Yang-Ci/Rebot-Arm/hardware/reBot_B601_DM/readme.md

# 🤖 reBot DevArm Open Source Hardware Specification

<p align="center">
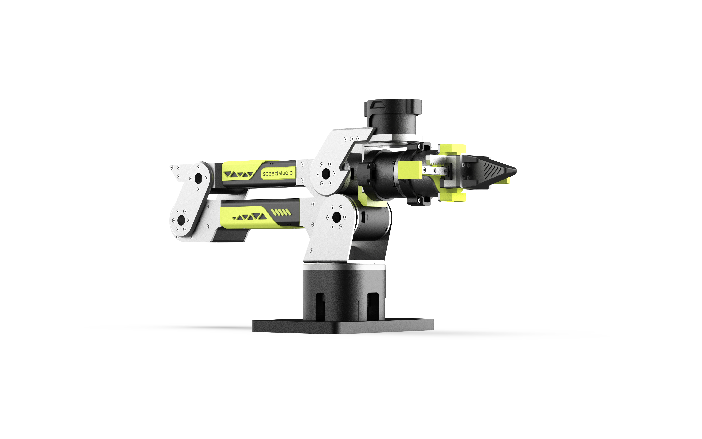
[picture p7: media/v1.1.png]
reBot-DevArm Banner
  
</p>
<p align="center">
  <strong>
    <a href="./readme_zh.md">简体中文</a> &nbsp;|&nbsp;
    <a href="./readme.md">English</a> &nbsp;|&nbsp;
    <a href="./readme_jp.md">日本語</a>&nbsp;|&nbsp;
    <a href="./readme_fr.md">français</a>&nbsp;|&nbsp;
    <a href="./readme_es.md">Español</a>
  </strong>
</p>

| Date | Version | File Name | Changelog |
|---|---|---|---|
|  2026-03-31 | v1.0 |  reBot_B601_DM_v1.0_20260331.step  | Initial upload |
|  2026-04-25 | v1.1 |  reBot_B601_DM_v1.1_20260425.step  | Added Cable Restraint for the 3 end joint motors to prevent loosening and disconnection. Fixed Joint 1 model from 4310 to 4340P. Added CNC part 02_Base_Reinforcement_Part.step at the bottom to enhance base rigidity. |

This BOM is for the reBot Arm B601 DM robotic arm, which uses Damiao 43 series motors. The other version, reBot Arm B601 RS, uses RobStride motors; [see the BOM here](../reBot_B601_RS/README.md).

# 📦 File Structure
*   3D_Printed_Parts/: Step files for all 3D printed parts.
*   Metal_Parts/: Step files for all CNC machined metal parts.
*   Purchased_Parts/: Step files for all purchased components.
*   reBot_B601_DM_v1.1_20260415.step: Full robotic arm assembly file.

# 🛒[Gets All Parts](https://www.seeedstudio.com/reBot-Arm-B601-DM-Bundle.html)
- We offer five kit options:
  - **Arm Body Motor Kit**: Includes only motors and wiring harnesses for the robotic arm.
  - **Arm Body Structural Kit**: Includes only mechanical structural components.
  - **Gripper Complete Kit**: Includes motors, wiring harnesses and structural components for the gripper.
  - **Full Kit**: Includes the complete set of the robotic arm body and gripper.
  - **Pre‑assembled Robotic Arm**: Fully assembled finished robotic arm.

# 📊 Bill of Materials (BOM)

> [!WARNING]
> Declaration: The published BOM does **not** represent the final shipping version from Seeed. This open-source v1.1 is optimized for developers to reproduce at minimal cost, with some non-essential details simplified.
> The final Seeed production version will include metal laser engraving for foolproofing, some 3D printed parts will be replaced with metal for durability, clearances and machining tolerances will be adjusted for factory variation (balancing precision and cost), and custom wiring (e.g., braided sleeve protection) will be added at extra cost. However, the mechanical structure remains identical.

---

## 🖨️ 3D Printed Parts

| Part Description | Image | File Name | Material | Qty | Notes |
|---|---|---|---|---|---|
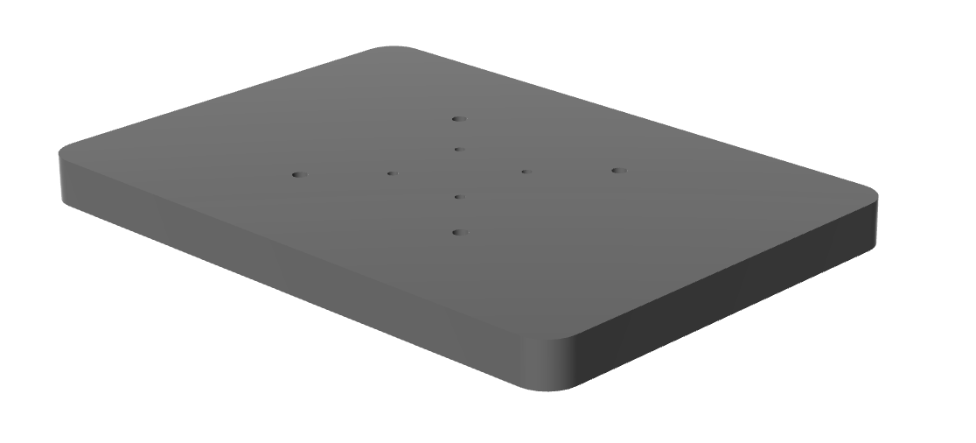
[picture p8: hardware/reBot_B601_DM/3D_Printed_Parts/images/02-BASE.png]
| Robotic Arm Base Platform |  | 01_BASE_Plate.step | Bambu ABS Black | 1 | 0.4 nozzle, 0.2 layer height, 30% infill |
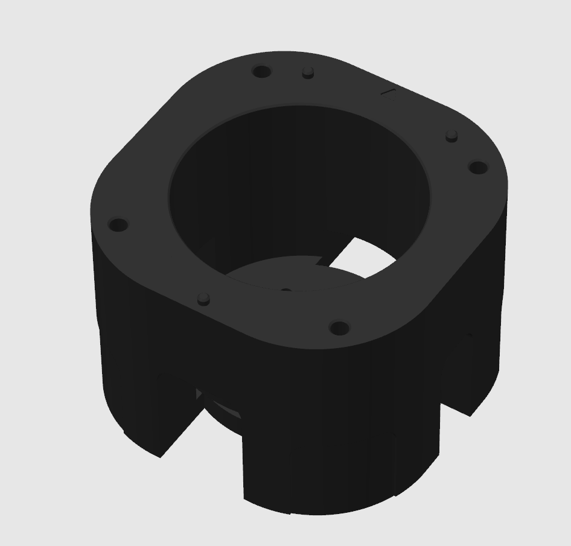
[picture p9: hardware/reBot_B601_DM/3D_Printed_Parts/images/02-BASE_02.png]
| Robotic Arm Base Link |  | 01_BASE_Link.step | Bambu ABS Black | 1 | 0.4 nozzle, 0.2 layer height, 30% infill |
| Upper Arm Left Filler |  | 01_Upper_Arm_Fuller_L.step | Bambu PLA Black & Green | 1 | 0.4 nozzle, 0.2 layer height, 15% infill |
| Upper Arm Right Filler |  | 01_Upper_Arm_Fuller_R.step | Bambu PLA Black & Green | 1 | 0.4 nozzle, 0.2 layer height, 15% infill |
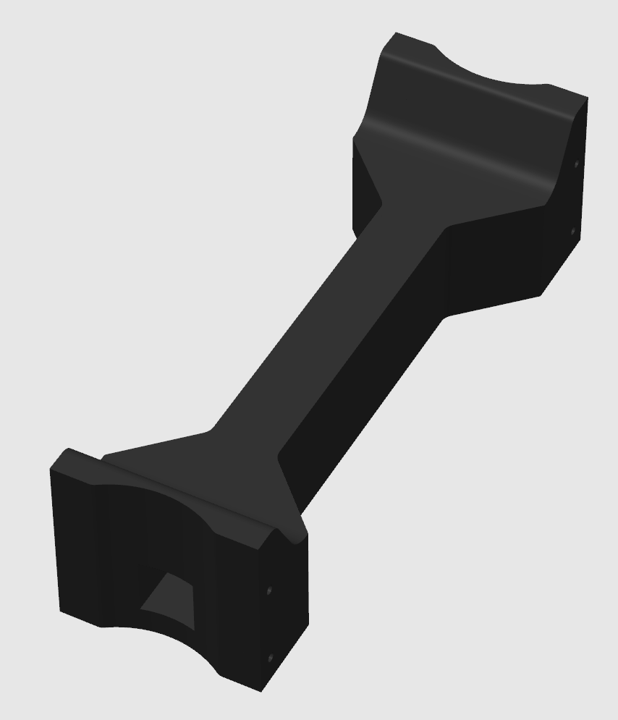
[picture p10: hardware/reBot_B601_DM/3D_Printed_Parts/images/02-DOWN-FILLING.png]
| Upper Arm Center Filler |  | 01_Upper_Arm_Fuller_M.step | Bambu ABS Black | 1 | 0.4 nozzle, 0.2 layer height, 30% infill |
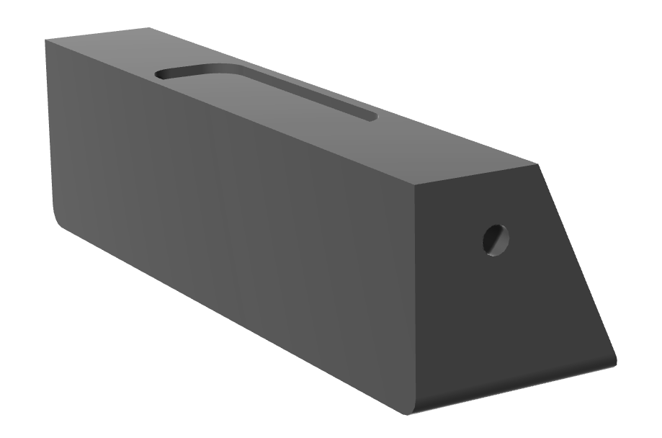
[picture p11: hardware/reBot_B601_DM/3D_Printed_Parts/images/02-SPACER-DOWN.png]
| Upper Arm Horizontal Limit Block |  | 01_Upper_Arm_Limit.step | Bambu ABS Black | 1 | 0.4 nozzle, 0.2 layer height, 30% infill |
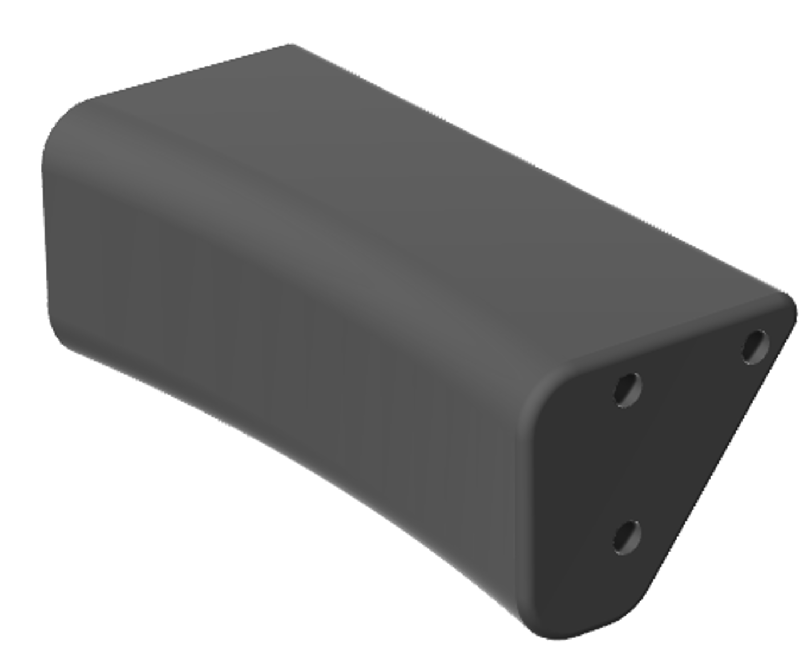
[picture p12: hardware/reBot_B601_DM/3D_Printed_Parts/images/02-HANDLE.png]
| Arm Handle |  | 01_Arm_Handle.step | Bambu ABS Black | 1 | 0.4 nozzle, 0.2 layer height, 30% infill |
| Lower Arm Left Filler |  | 01_Lower_Arm_Filler_L.step | Bambu PLA Black & Green | 1 | 0.4 nozzle, 0.2 layer height, 15% infill |
| Lower Arm Right Filler |  | 01_Lower_Arm_Filler_R.step | Bambu PLA Black & Green | 1 | 0.4 nozzle, 0.2 layer height, 15% infill |
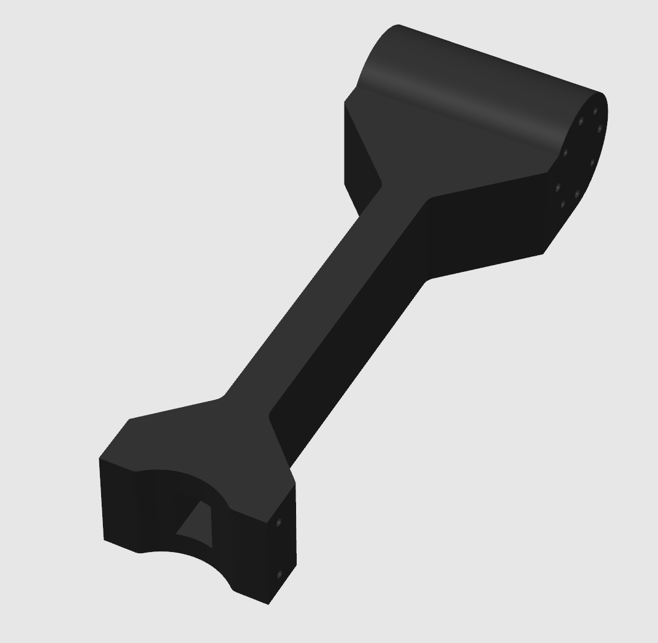
[picture p13: hardware/reBot_B601_DM/3D_Printed_Parts/images/02-UP-FILLING.png]
| Lower Arm Center Filler |  | 01_Lower_Arm_Filler_M.step | Bambu ABS Black | 1 | 0.4 nozzle, 0.2 layer height, 30% infill |
| Upper Arm Cover |  | 01_Upper_Arm_Cover.step | Bambu PLA Green | 1 | 0.4 nozzle, 0.2 layer height, 15% infill |
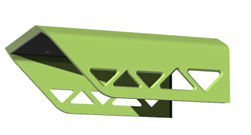
[picture p14: hardware/reBot_B601_DM/3D_Printed_Parts/images/02-UP-COVER.png]
| Lower Arm Cover |  | 01_Lower_Arm_Cover.step | Bambu PLA Green | 1 | 0.4 nozzle, 0.2 layer height, 15% infill |
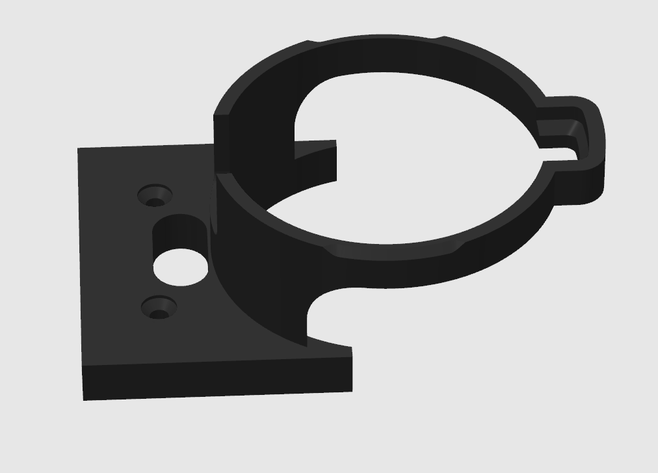
[picture p15: hardware/reBot_B601_DM/3D_Printed_Parts/images/02-MOTOR-COVER.png]
| Motor 5 Protection Cover |  | 01_Motor_Cover.step | Bambu ABS Black | 1 | 0.4 nozzle, 0.2 layer height, 30% infill |
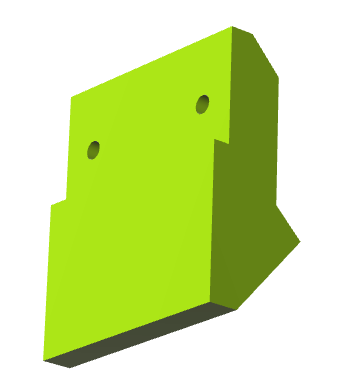
[picture p16: hardware/reBot_B601_DM/3D_Printed_Parts/images/02-SPACER.png]
| Gripper Horizontal Limit |  | 01_Lower_Arm_Limit.step | Bambu PLA Green | 1 | 0.4 nozzle, 0.2 layer height, 15% infill |
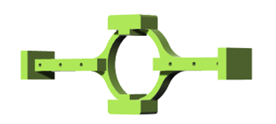
[picture p17: hardware/reBot_B601_DM/3D_Printed_Parts/images/02-3D-RAIL-BRACKET.png]
| Gripper Slider Support Bracket |  | 01-Rail-Bracket.step | Bambu PLA Green | 1 | 0.4 nozzle, 0.2 layer height, 15% infill |
| Gripper Finger |  | 01_Finger.step | Bambu ABS Black | 2 | 0.4 nozzle, 0.2 layer height, 45% infill |
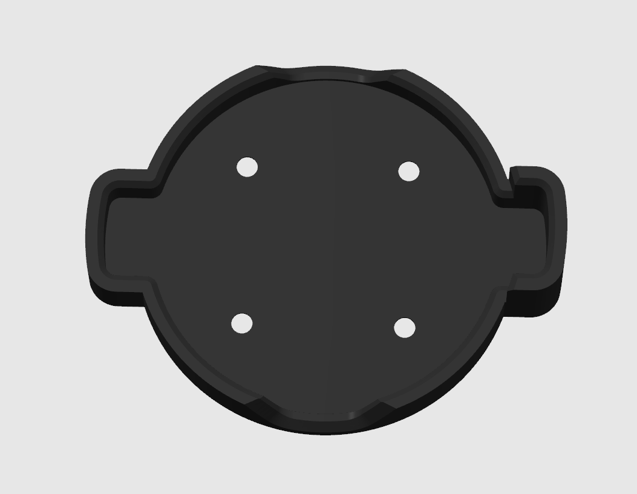
[picture p18: hardware/reBot_B601_DM/3D_Printed_Parts/images/01_Joint5_Cable Restraint_A.png]
| Motor 5 Cable Restraint |  | 01_Joint5_Cable Restraint_A.step | Bambu PLA Green | 1 | 0.4 nozzle, 0.2 layer height, 15% infill |
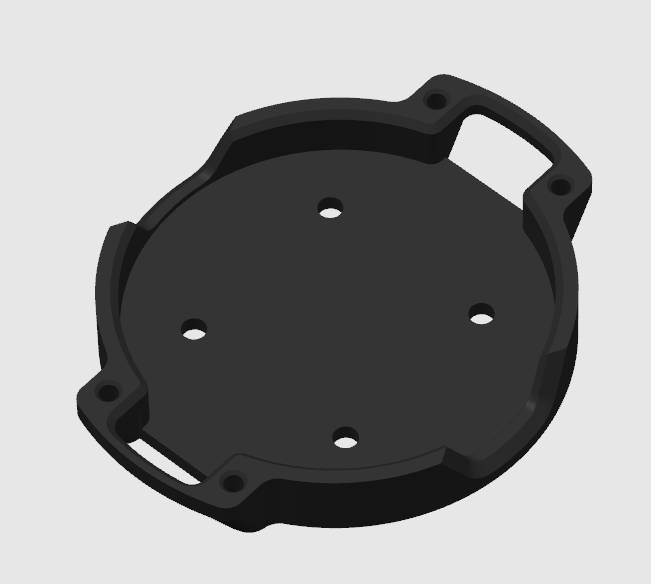
[picture p19: hardware/reBot_B601_DM/3D_Printed_Parts/images/01_Joint6_7_Cable Restraint_A.png]
| Motor 6 & 7 Cable Restraint A |  | 01_Joint6_7_Cable Restraint_A.step | Bambu ABS Black | 2 | 0.4 nozzle, 0.2 layer height, 30% infill |
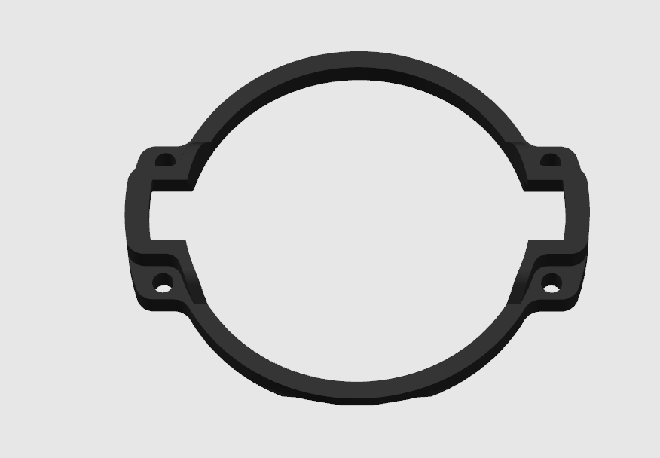
[picture p20: hardware/reBot_B601_DM/3D_Printed_Parts/images/01_Joint6_7_Cable Restraint_B.png]
| Motor 6 & 7 Cable Restraint B |  | 01_Joint6_7_Cable Restraint_B.step | Bambu ABS Black | 2 | 0.4 nozzle, 0.2 layer height, 30% infill |
| - | Reference Price | Average **50$** | | | Price varies by material cost and printing time |

### 🧩 Printing Recommendations
- Layer height: 0.2 mm
- Nozzle: 0.4 mm
- Supports: Add as needed
- Materials: High-temperature and load-bearing parts use ABS with 30–80% infill; may also use nylon or carbon-fiber reinforced materials. Cosmetic parts use PLA with 15% infill.
- Recommended materials for load-bearing parts:

---

## 🔩 CNC Machined Metal Parts

> [!WARNING]
> Some parts that can be replaced with 3D printing are noted in the remarks, which can significantly reduce costs.

| Part Description | Image | File Name | Material | Qty | Machining | Notes |
|---|---|---|---|---|---|---|
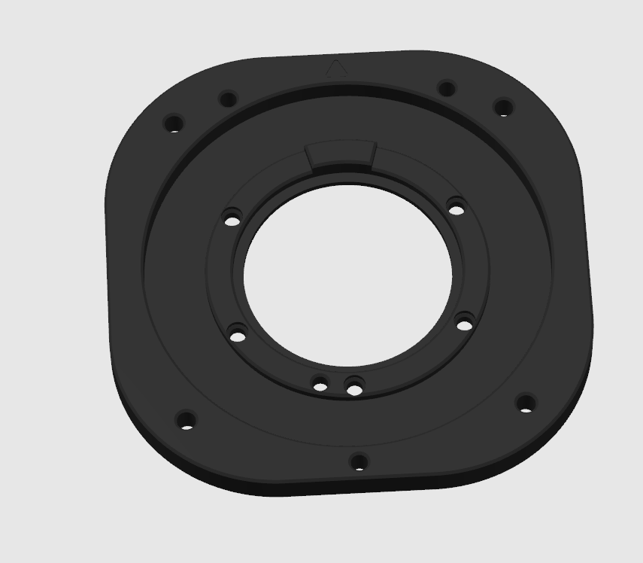
[picture p21: hardware/reBot_B601_DM/Metal_Parts/images/02_Base_Reinforcement_Part.png]
| Motor 1 Bearing Mount |  | 02_Base_Reinforcement_Part.step | Aluminum Alloy 5052 | 1 | CNC | Can be 3D printed in ABS with high infill to reduce cost |
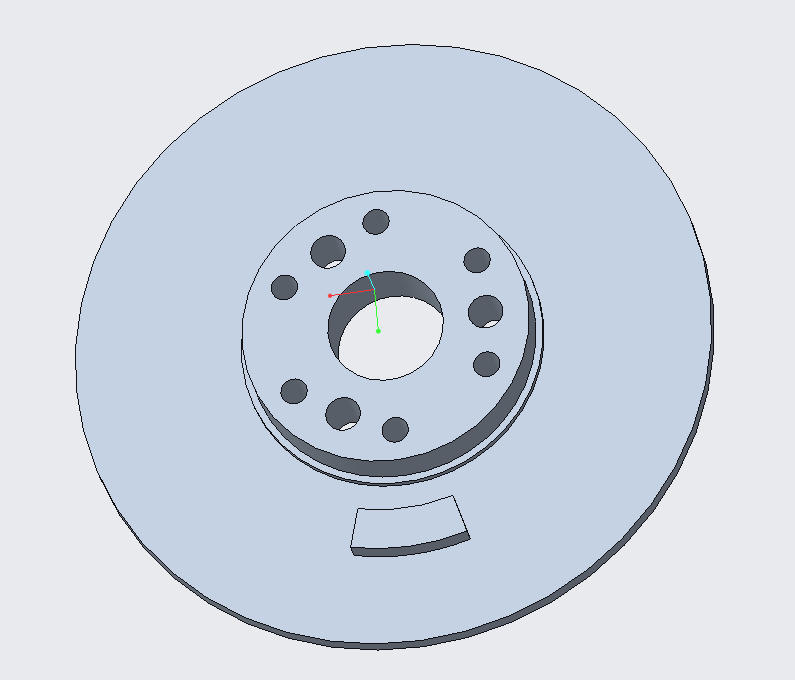
[picture p22: hardware/reBot_B601_DM/Metal_Parts/images/02_Arm_Yaw_Limit.png]
| Motor 1 Rotation Axis |  | 02_Arm_Yaw_Limit.step | Aluminum Alloy 5052 | 1 | CNC | Added yaw angle motion limit |
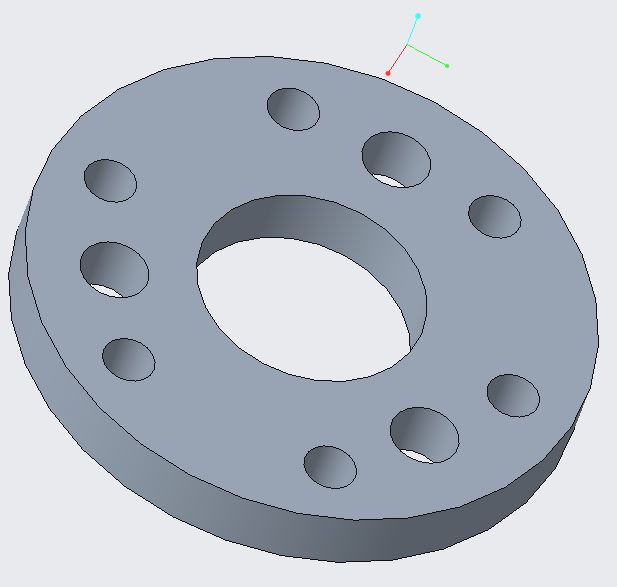
[picture p23: hardware/reBot_B601_DM/Metal_Parts/images/02_Motor_Front_Spacer.png]
| Motor 2–5 Front Spacer |  | 02_Motor_Front_Spacer.step | Aluminum Alloy 5052 | 4 | CNC | Can be 3D printed in ABS with 30% infill |
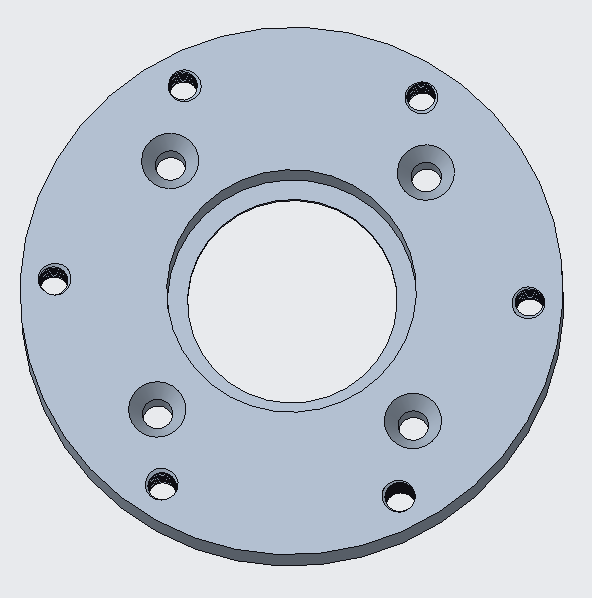
[picture p24: hardware/reBot_B601_DM/Metal_Parts/images/02_Motor_Back_Spacer.png]
| Motor 2–4 Rear Spacer |  | 02_Motor_Back_Spacer.step | Aluminum Alloy 5052 | 3 | CNC | |
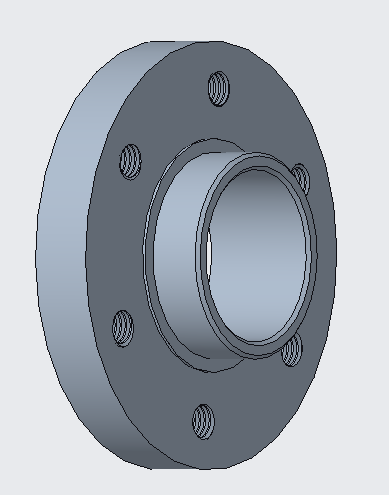
[picture p25: hardware/reBot_B601_DM/Metal_Parts/images/02_FLANGE.png]
| Motor 2–4 Rear Flange |  | 02_FLANGE.step | Aluminum Alloy 5052 | 3 | CNC | |
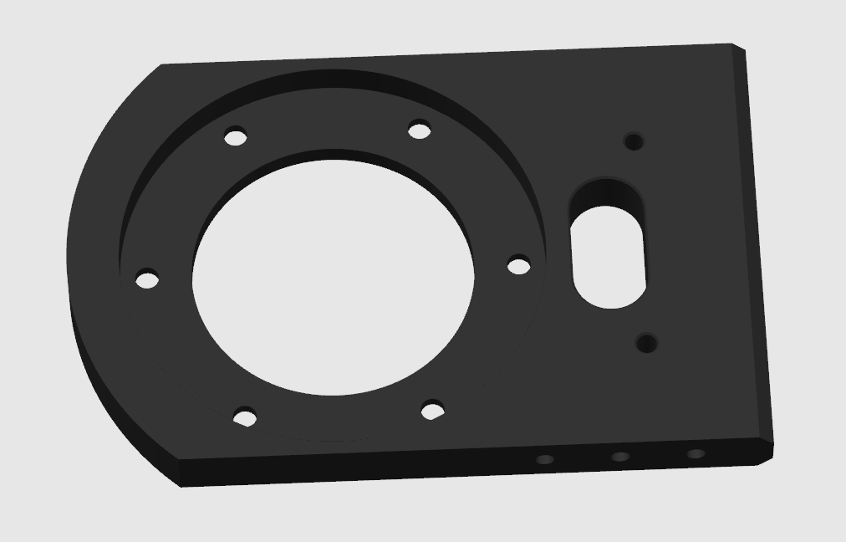
[picture p26: hardware/reBot_B601_DM/Metal_Parts/images/02_Wrist_Bracket.png]
| Wrist Motor 5 Bracket |  | 02_Wrist_Bracket.step | Aluminum Alloy 5052 | 1 | CNC | |
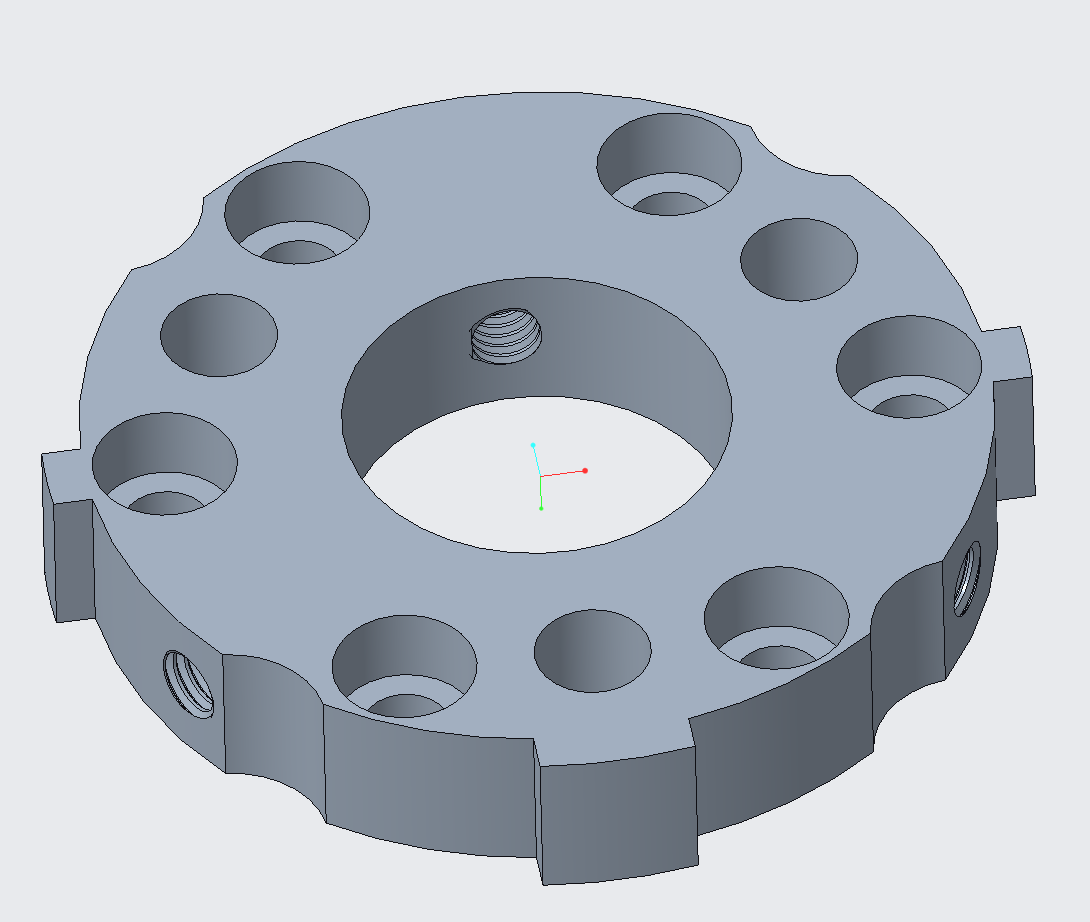
[picture p27: hardware/reBot_B601_DM/Metal_Parts/images/02_Gripper_Connector_A.png]
| Gripper Connector A |  | 02_Gripper_Connector_A.step | Aluminum Alloy 5052 | 1 | CNC | |
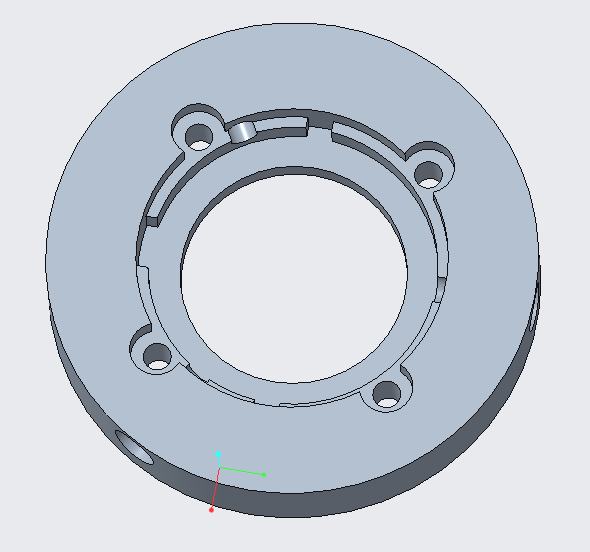
[picture p28: hardware/reBot_B601_DM/Metal_Parts/images/02_Gripper_Connector_B.png]
| Gripper Connector B |  | 02_Gripper_Connector_B.step | Aluminum Alloy 5052 | 1 | CNC | |
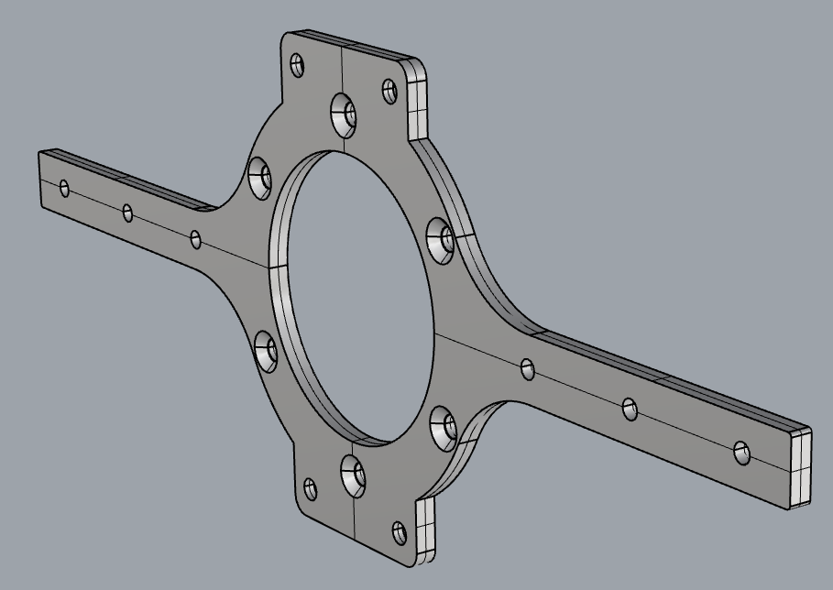
[picture p29: hardware/reBot_B601_DM/Metal_Parts/images/02_Slider_Bracket.png]
| Gripper Slider Metal Bracket |  | 02_Slider_Bracket.step | Aluminum Alloy 5052 | 1 | CNC | Can be 3D printed in ABS with high infill, not recommended for long-term use |
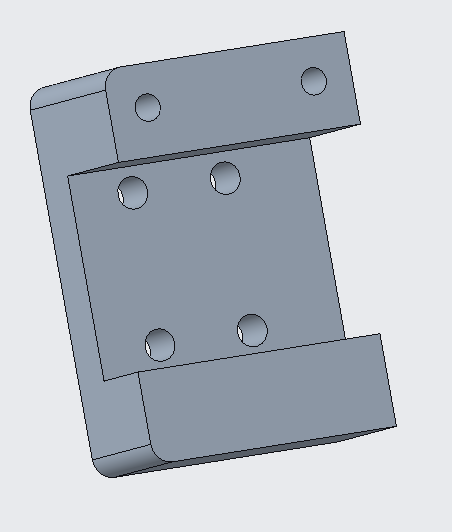
[picture p30: hardware/reBot_B601_DM/Metal_Parts/images/02_Slider_Extension.png]
| Slider to Gripper Extension |  | 02_Slider_Extension.step | Aluminum Alloy 5052 | 2 | CNC | |
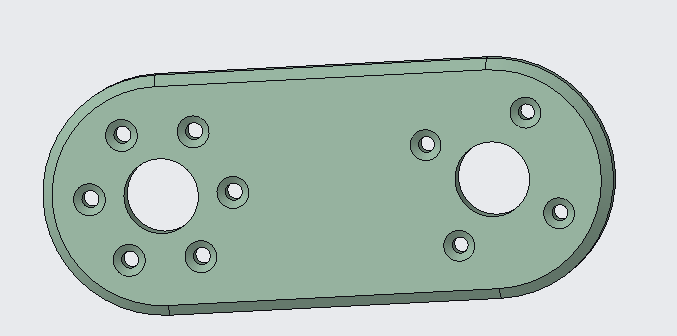
[picture p31: hardware/reBot_B601_DM/Metal_Parts/images/02_Lower_Upper_Link_L.png]
| Upper-Lower Arm Link Left |  | 02_Lower_Upper_Link_L.step | Aluminum Alloy 5052 | 1 | CNC | |
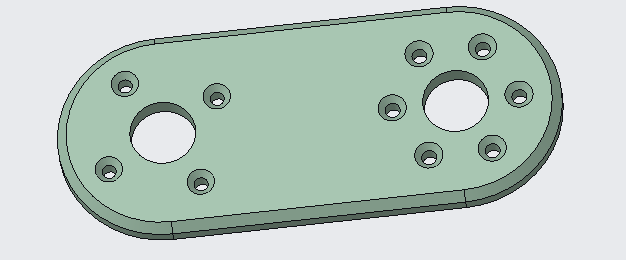
[picture p32: hardware/reBot_B601_DM/Metal_Parts/images/02_Lower_Upper_Link_R.png]
| Upper-Lower Arm Link Right |  | 02_Lower_Upper_Link_R.step | Aluminum Alloy 5052 | 1 | CNC | |
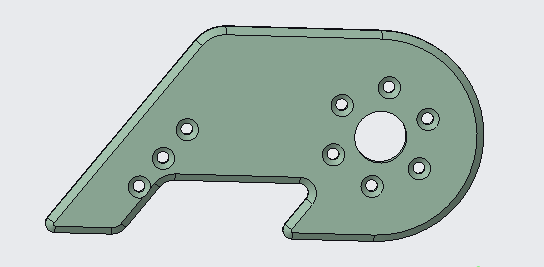
[picture p33: hardware/reBot_B601_DM/Metal_Parts/images/02_Lower_Wrist_Link_L.png]
| Lower Arm-Wrist Link Left |  | 02_Lower_Wrist_Link_L.step | Aluminum Alloy 5052 | 1 | CNC | |
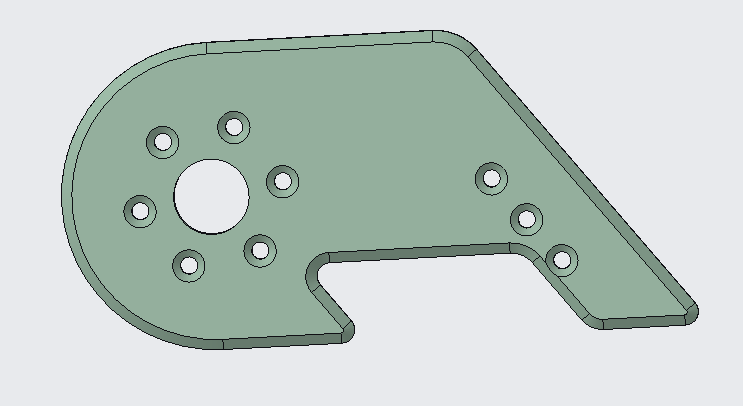
[picture p34: hardware/reBot_B601_DM/Metal_Parts/images/02_Lower_Wrist_Link_R.png]
| Lower Arm-Wrist Link Right |  | 02_Lower_Wrist_Link_R.step | Aluminum Alloy 5052 | 1 | CNC | |
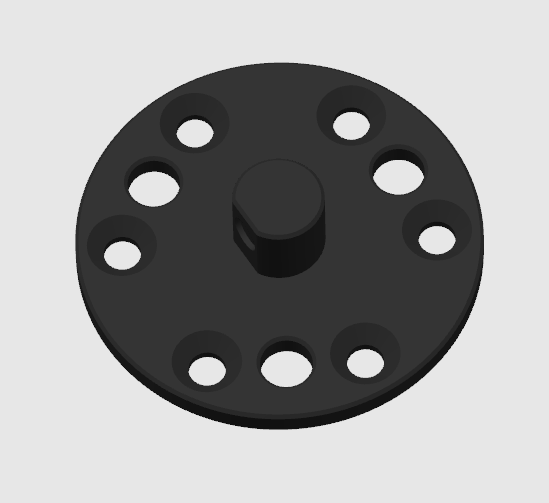
[picture p35: hardware/reBot_B601_DM/Metal_Parts/images/02_Gear_Connector.png]
| Gear Connector |  | 02_Gear_Connector.step | Aluminum Alloy 5052 | 1 | CNC | |
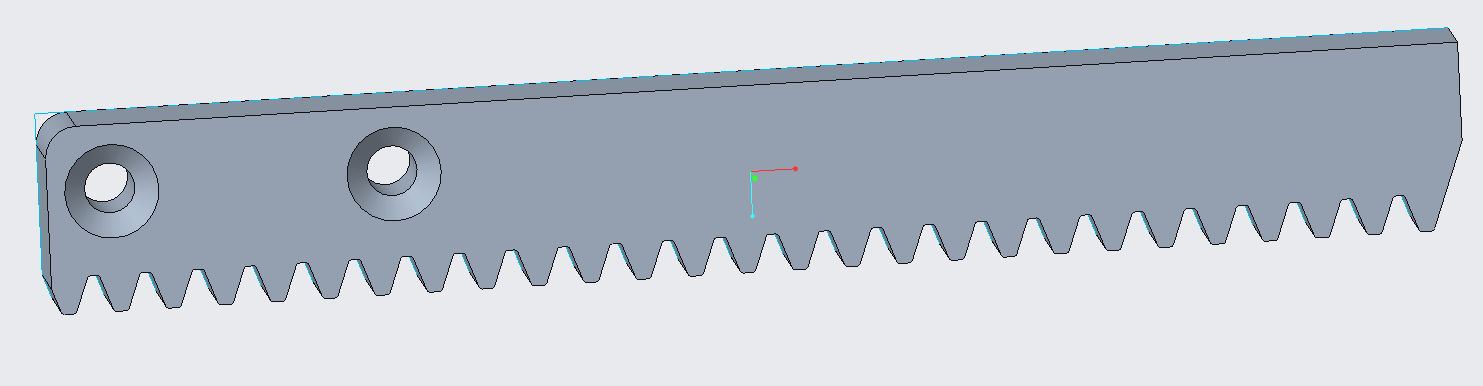
[picture p36: hardware/reBot_B601_DM/Metal_Parts/images/Rack.png]
| Rack |  | 02_Rack.step | Aluminum Alloy 5052 | 2 | CNC | |
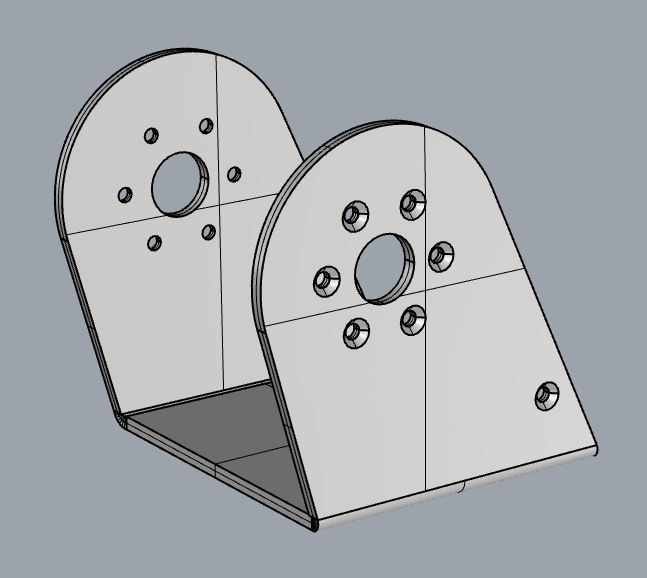
[picture p37: hardware/reBot_B601_DM/Metal_Parts/images/Link1.png]
| Link 1 |  | 03_Link1.step | Aluminum Alloy 5052 | 1 | CNC + Sheet Metal | |
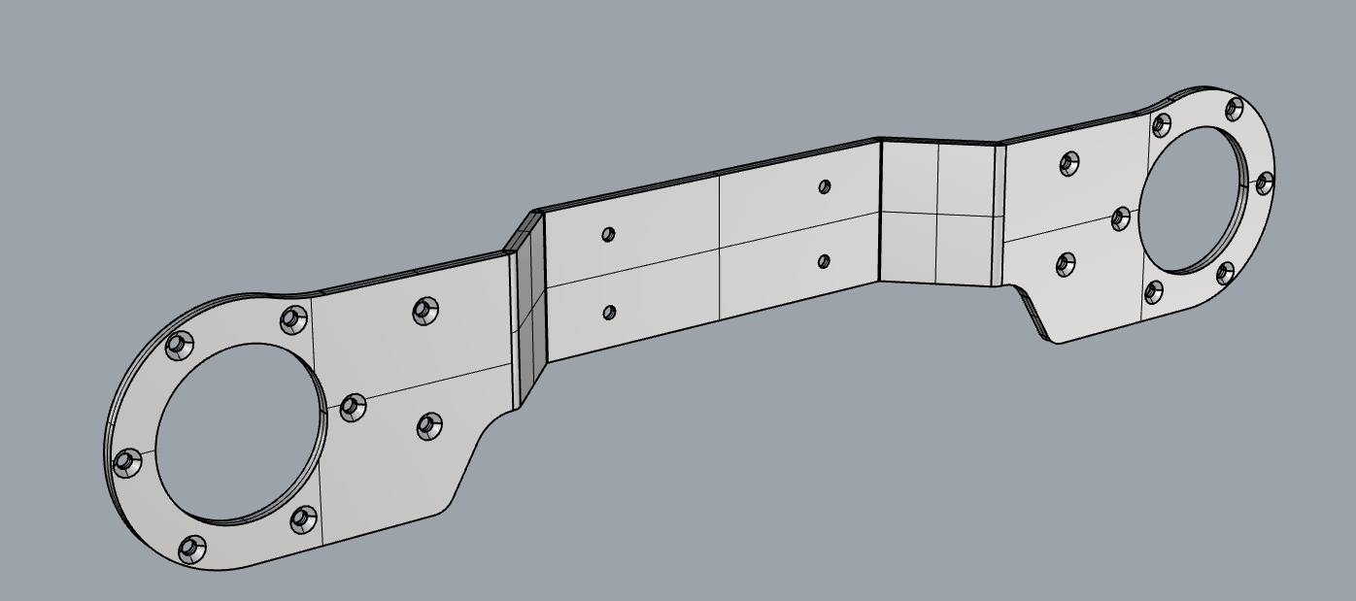
[picture p38: hardware/reBot_B601_DM/Metal_Parts/images/Link2.png]
| Link 2 |  | 03_Link2.step | Aluminum Alloy 5052 | 2 | CNC + Sheet Metal | |
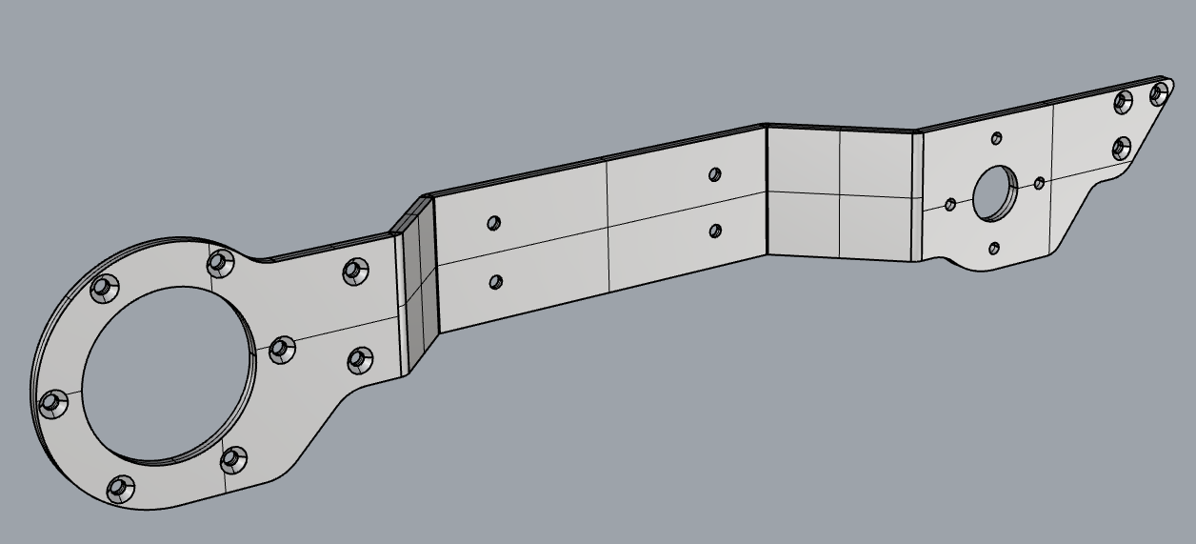
[picture p39: hardware/reBot_B601_DM/Metal_Parts/images/Link3_L.png]
| Link 3 Left |  | 03_Link3_L.step | Aluminum Alloy 5052 | 1 | CNC + Sheet Metal | |
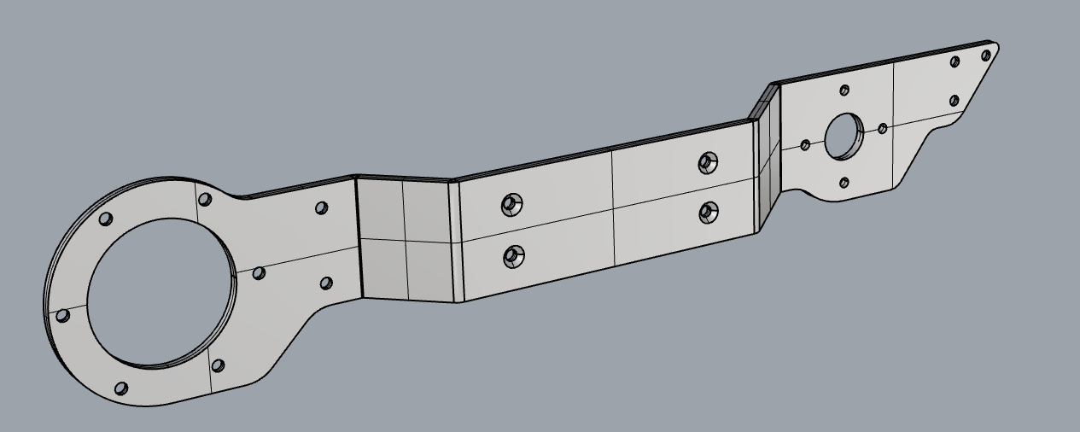
[picture p40: hardware/reBot_B601_DM/Metal_Parts/images/Link3_R.png]
| Link 3 Right |  | 03_Link3_R.step | Aluminum Alloy 5052 | 1 | CNC + Sheet Metal | |
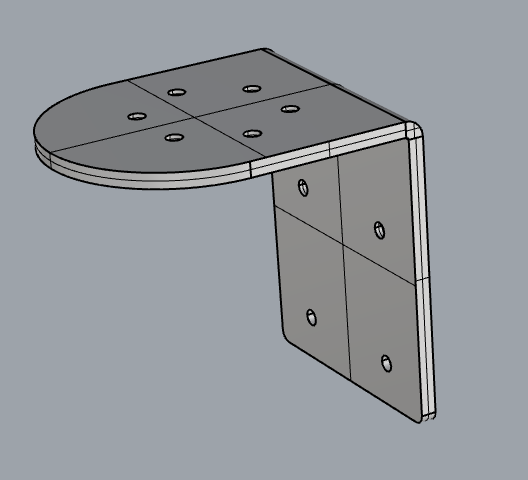
[picture p41: hardware/reBot_B601_DM/Metal_Parts/images/Link5.png]
| Link 5 |  | 03_Link5.step | Aluminum Alloy 5052 | 1 | CNC + Sheet Metal | |
| - | Market Reference Price | Average **250$** | | | Price varies by aluminum cost, tolerance requirements, lead time |

### 🧩 Machining Specifications
- Key dimension tolerance: ±0.02 mm GB/T1840-M
- Surface finish: Anodizing / Sandblasting
- Mating parts recommended: H7 / interference fit
---

## 🛒 Purchased Parts (Standard Parts)

> [!WARNING]
> Since everyone will need to assemble and tighten the screws themselves, standard hex socket screws have been selected. After prolonged operation, the screws may loosen, which will affect the precision of the robotic arm. For this reason, you are required to purchase additional hot melt glue to perform thread locking on the screws at each joint.

If you have a power drill or similar tools, you may choose to buy lock washers or thread-locking screws instead. However, **it is extremely important** that you use the lowest torque setting when using an electric screwdriver to avoid thread stripping, which will result in irreversible damage.

  | Name | Specification / Model | Quantity | Reference Price | Notes |
  |------|----------|------|----------|------|
  | Brushless motor | DM4310(V4) | 4 | 120 $/unit | [SeeedStudio](https://www.seeedstudio.com/DIP-Servo-Motor-24V-120RPM-Brushless-98-9mm-4P-L56-W56-H46mm-p-6660.html) |
  | Brushless motor | DM4340P(V4) | 3 | 175 $/unit |  [SeeedStudio](https://www.seeedstudio.com/DM4340P-Actuator-p-6663.html)  |
  | CAN-USB driver board |  | 1 | 15 $/unit |   [SeeedStudio](https://www.seeedstudio.com/DM-CAN-USB-Driver-Borad-p-6706.html)   |
  | Bearing | 6707ZZ | 1 | 13 $/unit | [Amazong](https://www.amazon.com/uxcell-35x44x5mm-Shielded-Precision-Lubricated/dp/B0D6WBMW3F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) |
  | Bearing | 6803ZZ | 3 | 13 $/unit | [Amazong](https://www.amazon.com/uxcell-17x26x5mm-Shielded-Precision-Lubricated/dp/B0D54JSWBZ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) |
  | Bearing | AXK5578 | 1 | 12 $/unit | [Amazong](https://www.amazon.com/PZRT-AXK5578-Thrust-Bearings-Washers/dp/B0B3M3RZGW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) |
  | Linear rail | MGN9-170mm | 1 | 23 $/unit | [Amazong](https://www.amazon.com/uxcell-Sliding-Carriage-Bearing-Printers/dp/B0D54L45WM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) |
  | Slider block | MGN9 | 2 | 10 $/unit | [Amazong](https://www.amazon.com/uxcell-Bearing-Sliding-Carriage-Anti-Fall/dp/B0D9QBQDKB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) |
  | Gear | Module 1, boss type, 16 teeth, 6 mm bore | 1 | 44$/unit | [Amazong](https://www.amazon.com/Module-15-Teeth-Finished-Perforation/dp/B0GDSR1LKM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)  |
  | Silicone pad | 30x9x2mm | 1 | 10 $ | [Amazong](https://www.amazon.com/Self-Adhesive-Anti-Sliding-Anti-Scratch-Protectors-Appliances/dp/B0F9KVYXFZ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) |
  | Screw | HM3-12mm screw | 14+ |  | [Amazong](https://www.amazon.com/BNUOK-120pcs-Stainless-Threads-Spanner/dp/B0DJQGMQZM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) |
  | Screw | HM3-25mm screw | 14+ |  | [Amazong](https://www.amazon.com/BNUOK-120pcs-Stainless-Threads-Spanner/dp/B0DJQFGRPQ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)  |
  | Screw | HM3-6mm screw | 16+ |  | [Amazong](https://www.amazon.com/BNUOK-120pcs-Stainless-Threads-Spanner/dp/B0DJQG5YLF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)  |
  | Screw | HM4-75mm set screw | 4+ |  | [Amazong](https://www.amazon.com/iexcell-Partially-Threaded-Thread-Socket/dp/B0DR1NX178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)  |
  | Screw | KM3*12mm screw | 30+ |  |  [Amazong](https://www.amazon.com/Uxcell-a16011300ux0872-M3x12mm-Carbon-Countersunk/dp/B01E6EIC2S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) |
  | Screw | KM3*16mm screw | 34+ |  | [Amazong](https://www.amazon.com/Uxcell-a16011300ux0872-M3x12mm-Carbon-Countersunk/dp/B01E6EIC2S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)  |
  | Screw | KM3*7mm screw | 76+ |  |[Amazong](https://www.amazon.com/Uxcell-a16011300ux0872-M3x12mm-Carbon-Countersunk/dp/B01E6EIC2S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)   |
  | Screw | KM3*9mm screw | 31+ |  |[Amazong](https://www.amazon.com/Uxcell-a16011300ux0872-M3x12mm-Carbon-Countersunk/dp/B01E6EIC2S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)   |
  | Screw | KM3*8mm Socket Micro Profile Head Screw | 31+ |  |[Amazong](https://www.amazon.com/SMALLRIG-Screw-Screws-12pcs-Pack/dp/B01MS60KSY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)   |
  | Screw | KA3*12mm | 72+ |  | [Amazong](https://www.amazon.com/uxcell-Phillips-Tapping-Screws-Silver/dp/B01MXSS95N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)  |
  | Dowel pin | M4*8mm | Several |  | [Amazong](amazon.com/HARFINGTON-Stainless-Cylindrical-Furniture-Installation/dp/B0F6CWL4MP/ref=sr_1_6?crid=2BZ4J412S4QSB&dib=eyJ2IjoiMSJ9.a3kVMi6W355gYKjK1Sl_QFVcJD8x7DTXqxgk66DoY4TnPOEV9TG7AbW7jkNk2USTJrqrb3e5Ve0EeVwHVE-_s-UUP6jFahdiVAqkZGGnuBpVxwA-MCHYQEwThEfygwAc1HVyN1n7Cvr8GAFMvs5AfciRrbUZ8AsSNGc1Obgf8qouOe8NQhyW_Zo7YINX1m3YCuTRiLZCvB6o7XlZtZ4PRh085Bva6AjjnlNOuaiPCtzjvNUtTpyLpGmqoHM165V6onFghMcuOX9RaacnxQNsRoUtKpWPEB8h48nUnUOJ1lg.Hfy_mUj7QFR_kILC4I5RNy6h7HmdswULHg3NmKmK8bU&dib_tag=se&keywords=Dowel%2Bpin%2BM4*7&qid=1776331648&s=industrial&sprefix=dowel%2Bpin%2Bm4%2B%2Cindustrial%2C399&sr=1-6&th=1)  |
  | Dowel pin | M4*12mm | Several |  | [Amazong](amazon.com/HARFINGTON-Stainless-Cylindrical-Furniture-Installation/dp/B0F6CWL4MP/ref=sr_1_6?crid=2BZ4J412S4QSB&dib=eyJ2IjoiMSJ9.a3kVMi6W355gYKjK1Sl_QFVcJD8x7DTXqxgk66DoY4TnPOEV9TG7AbW7jkNk2USTJrqrb3e5Ve0EeVwHVE-_s-UUP6jFahdiVAqkZGGnuBpVxwA-MCHYQEwThEfygwAc1HVyN1n7Cvr8GAFMvs5AfciRrbUZ8AsSNGc1Obgf8qouOe8NQhyW_Zo7YINX1m3YCuTRiLZCvB6o7XlZtZ4PRh085Bva6AjjnlNOuaiPCtzjvNUtTpyLpGmqoHM165V6onFghMcuOX9RaacnxQNsRoUtKpWPEB8h48nUnUOJ1lg.Hfy_mUj7QFR_kILC4I5RNy6h7HmdswULHg3NmKmK8bU&dib_tag=se&keywords=Dowel%2Bpin%2BM4*7&qid=1776331648&s=industrial&sprefix=dowel%2Bpin%2Bm4%2B%2Cindustrial%2C399&sr=1-6&th=1)  |
  | Screwdriver set | Hex key set | 1 | 16$  | [Amazong](amazon.com/Amazon-Basics-Ratcheting-Electronics-Screwdriver/dp/B07V4TFWFZ/ref=sr_1_2?crid=ADAY70RZDSLN&dib=eyJ2IjoiMSJ9.jcLL4o6IXTnPlPfTTzbCZCBuZx2sLkvdUQCwlL58aq__GOyLxVPnwLI0mvGptba_HeVz6ctLQ_ziQw56BMDH9IOaw-4PVJGMktQM74mWficwggm3ckDGyAH-agN_zkB3K0_W-wrS56jfcMYFbZSWhWxr-iSOC4sdXwMGlt4rYGtenyn9yAFYBIHqjU2El5_OAKuspsrF0yQvfyfQPQHs46SClWN8zlSemGVZRuVSU26f0f9yApF6BfWHANKNNhT0Mfb6bQ8oM2XUMvwaazrrKoHeTARuoflVaVZvMU776bs.r8gy_gMINEy0qy4JyK--z-IbPZEv-SWeMGohOOE7M60&dib_tag=se&keywords=Screwdriver+set&qid=1774772499&s=industrial&sprefix=screwdriver+set+%2Cindustrial%2C374&sr=1-2)  |
  |  | XT30 2+2 350mm | 2 | 4 $/cable | Both ends angled |
  |  | XT30 2+2 350mm | 1 | 4 $/cable | One angled end and one straight end |
  |  | XT30 2+2 200mm | 3 | 4 $/cable | Both ends angled |
  |  | XT30 2+2 200mm | 1 | 3 $/cable | Both ends straight |
  | Woodworking clamp | 6-inch G clamp | 2 | 20 $/unit | [Amazong](https://www.amazon.com/gp/aw/d/B092J1YW2M/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) |
  | Power supply | 24V 14.6A | 1 | 30$ | [Amazong](https://www.amazon.com/MEAN-WELL-LRS-350-24-350-4W-Switchable/dp/B013ETVO12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) |
  | Power Cable | 12AWG | 1 | 30 $ | [Amazong](https://www.amazon.com/Pinfox-Universal-Appliance-Replacement-Pigtail/dp/B0F5PW5SJG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) |
  | Power Cable | XT30 16awg | 1 | 9 $ | [Amazong](https://www.amazon.com/RioRand-Connector-Pigtail-Silicone-Aircraft/dp/B0FY2ZCR83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) |

  ---
