Yang-Ci/Rebot-Arm/hardware/reBot_B601_DM/readme_es.md

# 🤖 Descripción del hardware de código abierto reBot DevArm

<p align="center">
  Banner de reBot-DevArm
</p>
<p align="center">
  <strong>
    <a href="./readme_zh.md">简体中文</a> &nbsp;|&nbsp;
    <a href="./readme.md">English</a> &nbsp;|&nbsp;
    <a href="./readme_jp.md">日本語</a>&nbsp;|&nbsp;
    <a href="./readme_fr.md">français</a>&nbsp;|&nbsp;
    <a href="./readme_es.md">Español</a>
  </strong>
</p>

La BOM actual es la lista de componentes del brazo robótico **reBot Arm B601 DM**, que utiliza los **motores de la serie Damiao 43**. Otra versión, el brazo robótico **reBot Arm B601 RS**, utiliza **motores RobStride**. [Consulte la lista aquí](../reBot_B601_RS/README_zh.md)

# 📦 Estructura de archivos

* `3D_Printed_Parts/`: archivos STEP de todas las piezas impresas en 3D.
* `Metal_Parts/`: archivos STEP de todas las piezas metálicas mecanizadas.
* `Purchased_Parts/`: archivos STEP de todas las piezas compradas.
* `reBot_B601_DM_v1.0_20260425.step`: archivo de ensamblaje completo del brazo robótico.

# 📊 Lista de materiales (BOM)

> [!WARNING]
> Por la presente se declara: la BOM publicada **no** representa la versión final enviada por Seeed. Esta versión de código abierto `v1.1` está destinada a ayudar a los desarrolladores a reproducir el diseño por sí mismos con el menor costo posible y, por lo tanto, reduce algunos gastos innecesarios relacionados con detalles. La versión final enviada por Seeed incluirá detalles que aumentan el costo, como marcas antierrores grabadas con láser en las piezas metálicas, reemplazo de algunas piezas impresas en 3D por piezas metálicas para mayor durabilidad, ajustes de holgura y precisión de mecanizado basados en las tolerancias de las fábricas de procesamiento de metal (un equilibrio entre precisión y costo), personalización especial del arnés de cables (por ejemplo, añadiendo protección con malla trenzada) y otras optimizaciones de detalle. Sin embargo, la configuración estructural sigue siendo la misma.

---

## 🖨️ Piezas impresas en 3D

| Descripción de la pieza | Image | File Name | Material | Quantity | Notes |
|---|---|---|---|---|---|
| Plataforma base del brazo robótico |  | `01_BASE_Plate.step` | Bambu ABS Black | 1 | boquilla 0.4, altura de capa 0.2, relleno 30% |
| Base del brazo robótico |  | `01_BASE_Link.step` | Bambu ABS Black | 1 | boquilla 0.4, altura de capa 0.2, relleno 30% |
| Relleno izquierdo del brazo superior |  | `01_Upper_Arm_Fuller_L.step` | Bambu PLA Black and Green | 1 | boquilla 0.4, altura de capa 0.2, relleno 15% |
| Relleno derecho del brazo superior |  | `01_Upper_Arm_Fuller_R.step` | Bambu PLA Black and Green | 1 | boquilla 0.4, altura de capa 0.2, relleno 15% |
| Relleno central del brazo superior |  | `01_Upper_Arm_Fuller_M.step` | Bambu ABS Black | 1 | boquilla 0.4, altura de capa 0.2, relleno 30% |
| Tope horizontal del brazo superior |  | `01_Upper_Arm_Limit.step` | Bambu ABS Black | 1 | boquilla 0.4, altura de capa 0.2, relleno 30% |
| Asa del brazo robótico |  | `01_Arm_Handle.step` | Bambu ABS Black | 1 | boquilla 0.4, altura de capa 0.2, relleno 30% |
| Relleno izquierdo del antebrazo |  | `01_Lower_Arm_Filler_L.step` | Bambu PLA Black and Green | 1 | boquilla 0.4, altura de capa 0.2, relleno 15% |
| Relleno derecho del antebrazo |  | `01_Lower_Arm_Filler_R.step` | Bambu PLA Black and Green | 1 | boquilla 0.4, altura de capa 0.2, relleno 15% |
| Relleno central del antebrazo |  | `01_Lower_Arm_Filler_M.step` | Bambu ABS Black | 1 | boquilla 0.4, altura de capa 0.2, relleno 30% |
| Cubierta decorativa del brazo superior |  | `01_Upper_Arm_Cover.step` | Bambu PLA Green | 1 | boquilla 0.4, altura de capa 0.2, relleno 15% |
| Cubierta decorativa del antebrazo |  | `01_Lower_Arm_Cover.step` | Bambu PLA Green | 1 | boquilla 0.4, altura de capa 0.2, relleno 15% |
| Cubierta protectora del motor n.º 5 |  | `01_Motor_Cover.step` | Bambu ABS Black | 1 | boquilla 0.4, altura de capa 0.2, relleno 30% |
| Tope horizontal de la pinza |  | `01_Lower_Arm_Limit.step` | Bambu PLA Green | 1 | boquilla 0.4, altura de capa 0.2, relleno 15% |
| Soporte de relleno del deslizador de la pinza |  | `01-Rail-Bracket.step` | Bambu PLA Green | 1 | boquilla 0.4, altura de capa 0.2, relleno 15% |
| Pinza |  | `01_Finger.step` | Bambu ABS Black | 2 | boquilla 0.4, altura de capa 0.2, relleno 45% |
|  | `Reference price` | Promedio **50 $** |  |  | El precio puede variar ligeramente según el precio del material de impresión y el tiempo de impresión de la fábrica |

### 🧩 Recomendaciones de impresión

- Altura de capa: 0.2 mm
- Boquilla: 0.4 mm
- Soportes: añadir según sea necesario
- Materiales: las piezas que necesitan soportar calor y cierta fuerza utilizan material ABS con un relleno del 30% al 80%, y también pueden cambiarse a materiales de nailon / reforzados con fibra de carbono; las piezas de apariencia/decorativas utilizan PLA con un relleno del 15%.
- Materiales recomendados para piezas portantes:

---

## 🔩 Piezas metálicas mecanizadas

> [!WARNING]
> Algunas piezas que pueden sustituirse por impresión 3D se indican en las notas a continuación, lo que puede reducir aún más considerablemente los costos.

| Descripción de la pieza | Image | File Name | Material | Quantity | Manufacturing Process | Notes |
|---|---|---|---|---|---|---|
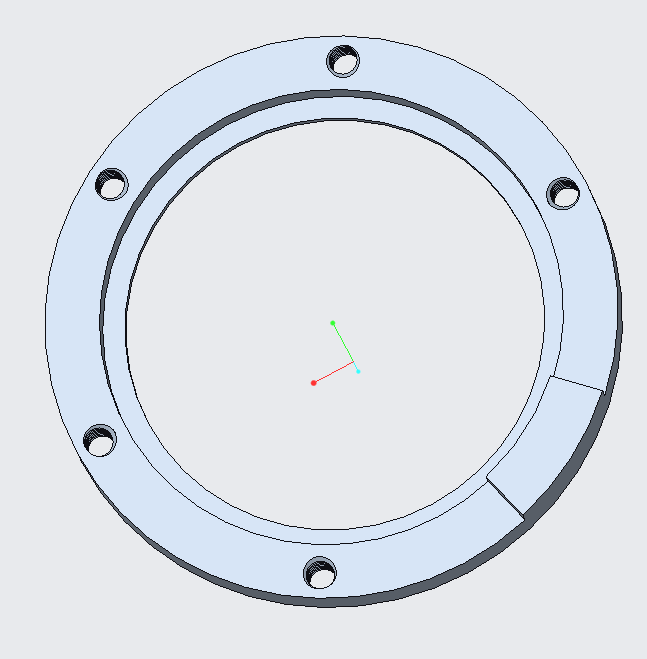
[picture p42: hardware/reBot_B601_DM/Metal_Parts/images/02_Base_Motor_Shim.png]
| Posición de montaje del rodamiento del motor 1 |  | `02_Base_Motor_Shim.step` | Aleación de aluminio 5052 | 1 | CNC | Puede sustituirse por ABS impreso en 3D con mayor relleno para reducir costos |
| Eje giratorio del motor 1 |  | `02_Arm_Yaw_Limit.step` | Aleación de aluminio 5052 | 1 | CNC | Añade límite de movimiento del ángulo de guiñada |
| Espaciador frontal para los motores 2-5 |  | `02_Motor_Front_Spacer.step` | Aleación de aluminio 5052 | 4 | CNC | Puede sustituirse por ABS impreso en 3D, relleno 30%, para reducir costos |
| Espaciador trasero para los motores 2-4 |  | `02_Motor_Back_Spacer.step` | Aleación de aluminio 5052 | 3 | CNC |  |
| Brida trasera para los motores 2-4 |  | `02_FLANGE.step` | Aleación de aluminio 5052 | 3 | CNC |  |
| Base del motor de muñeca 5 |  | `02_Wrist_Bracket.step` | Aleación de aluminio 5052 | 1 | CNC |  |
| Conector de pinza A |  | `02_Gripper_Connector_A.step` | Aleación de aluminio 5052 | 1 | CNC |  |
| Conector de pinza B |  | `02_Gripper_Connector_B.step` | Aleación de aluminio 5052 | 1 | CNC |  |
| Soporte metálico del deslizador de la pinza |  | `02_Slider_Bracket.step` | Aleación de aluminio 5052 | 1 | CNC | Puede sustituirse por ABS impreso en 3D con mayor relleno para reducir costos, pero no se recomienda para uso a largo plazo |
| Deslizador y conector de pinza |  | `02_Slider_Extension.step` | Aleación de aluminio 5052 | 2 | CNC |  |
| Conector izquierdo de la articulación entre brazo superior e inferior |  | `02_Lower_Upper_Link_L.step` | Aleación de aluminio 5052 | 1 | CNC |  |
| Conector derecho de la articulación entre brazo superior e inferior |  | `02_Lower_Upper_Link_R.step` | Aleación de aluminio 5052 | 1 | CNC |  |
| Conector izquierdo de la articulación entre antebrazo y muñeca |  | `02_Lower_Wrist_Link_L.step` | Aleación de aluminio 5052 | 1 | CNC |  |
| Conector derecho de la articulación entre antebrazo y muñeca |  | `02_Lower_Wrist_Link_R.step` | Aleación de aluminio 5052 | 1 | CNC |  |
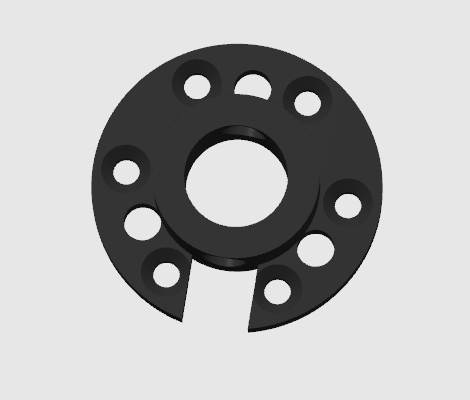
[picture p43: hardware/reBot_B601_DM/Metal_Parts/images/02-8MM.png]
| Conector de engranaje |  | `02_Gear_Connector.step` | Aleación de aluminio 5052 | 1 | CNC | Para baja carga, puede utilizarse ABS impreso en 3D con relleno del 80% para reducir costos; para alta carga, se recomienda mecanizado CNC en metal |
| Cremallera |  | `02_Rack.step` | Aleación de aluminio 5052 | 2 | CNC |  |
| Link 1 |  | `03-Link1.step` | Aleación de aluminio 5052 | 1 | CNC + chapa metálica |  |
| Link 2 |  | `03-Link2.step` | Aleación de aluminio 5052 | 2 | CNC + chapa metálica |  |
| Link 3 izquierdo |  | `03-Link3_L.step` | Aleación de aluminio 5052 | 1 | CNC + chapa metálica |  |
| Link 3 derecho |  | `03-Link3_R.step` | Aleación de aluminio 5052 | 1 | CNC + chapa metálica |  |
| Link 5 |  | `03-Link5.step` | Aleación de aluminio 5052 | 1 | CNC + chapa metálica |  |
| Precio de referencia de mercado múltiple |  | Promedio **250 $** |  |  |  | El precio puede variar ligeramente debido a las fluctuaciones del costo del aluminio 5052, los requisitos de precisión de mecanizado, el plazo de entrega de la fábrica, etc. |

### 🧩 Instrucciones de mecanizado

- Tolerancia dimensional crítica: ±0.02 mm, GB/T1840-M;
- Tratamiento superficial: anodizado / arenado
- Se recomienda usar H7 / ajuste por interferencia en las piezas de acoplamiento

---

## 🛒 Piezas compradas (piezas estándar)

> [!WARNING]
> Dado que todos tendrán que armar y atornillar por su cuenta, se han seleccionado tornillos hexagonales internos estándar. Después de un funcionamiento prolongado, los tornillos pueden aflojarse y afectar la precisión del brazo robótico.
Por ello, es necesario comprar adicionalmente pegamento termofusible para realizar un tratamiento antiflojamiento en los tornillos de cada articulación. Si disponen de taladro eléctrico u otras herramientas, pueden adquirir tornillos antiflojamiento. Sin embargo, es muy importante usar la potencia mínima con el destornillador eléctrico para evitar dañar la rosca y causar pérdidas irreversibles.

| Name | Specification / Model | Quantity | Reference Price | Notes |
|---|---|---|---|---|
| Motor sin escobillas | DM4310(V4) | 4 | 120 $/unit | [SeeedStudio](https://www.seeedstudio.com/DIP-Servo-Motor-24V-120RPM-Brushless-98-9mm-4P-L56-W56-H46mm-p-6660.html) |
| Motor sin escobillas | DM4340P(V4) | 3 | 175 $/unit |  [SeeedStudio](https://www.seeedstudio.com/DM4340P-Actuator-p-6663.html)  |
| Placa controladora CAN-USB |  | 1 | 15 $/unit | [SeeedStudio](https://www.seeedstudio.com/DM-CAN-USB-Driver-Borad-p-6706.html) |
| Rodamiento | 6707ZZ | 1 | 13 $/unit | [Amazong](https://www.amazon.com/uxcell-35x44x5mm-Shielded-Precision-Lubricated/dp/B0D6WBMW3F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) |
| Rodamiento | 6803ZZ | 3 | 13 $/unit | [Amazong](https://www.amazon.com/uxcell-17x26x5mm-Shielded-Precision-Lubricated/dp/B0D54JSWBZ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) |
| Rodamiento | AXK5578 | 1 | 12 $/unit | [Amazong](https://www.amazon.com/PZRT-AXK5578-Thrust-Bearings-Washers/dp/B0B3M3RZGW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) |
| Riel lineal | MGN9-170mm | 1 | 23 $/unit | [Amazong](https://www.amazon.com/uxcell-Sliding-Carriage-Bearing-Printers/dp/B0D54L45WM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) |
| Bloque deslizante | MGN9 | 2 | 10 $/unit | [Amazong](https://www.amazon.com/uxcell-Bearing-Sliding-Carriage-Anti-Fall/dp/B0D9QBQDKB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) |
| Engranaje | Módulo 1, tipo cubo, 16 dientes, agujero de 6 mm | 1 | 44$/unit | [Amazong](https://www.amazon.com/Module-15-Teeth-Finished-Perforation/dp/B0GDSR1LKM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)  |
| Almohadilla de silicona | 30*9*2mm | 1 | 10 $ | [Amazong](https://www.amazon.com/Self-Adhesive-Anti-Sliding-Anti-Scratch-Protectors-Appliances/dp/B0F9KVYXFZ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) |
| Separador de cobre | M4x50mm | 4 | 8 $ | [Amazong](https://www.amazon.com/Female-Standoff-Quadcopter-Computer-Circuit/dp/B09V2CYDMG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) |
| Tornillo | Tornillo M3*22mm | Several |  | [Amazong](https://www.amazon.com/METERXITY-50-Pack-Stainless-Threaded-Fasteners/dp/B0FLYG7WZ7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)  |
| Tornillo | Tornillo M4*16mm | Several |  | [Amazong](amazon.com/BNUOK-120pcs-Stainless-Threads-Spanner/dp/B0DYNFFB7Q/ref=sr_1_9?crid=W94HLTGLCH57&dib=eyJ2IjoiMSJ9.jg07IMpJdHhW8vR9Ewx53UNnQs_QkpENya6ZqIQWoB6rsXjPLmfWMgAytRy7neNPJJHQzVyP9H7FO5sm9KN9I34nKUQsLRZAG48Rs2rSHwlh2mpA2IPlezHLRlvLN49IIbiHgk5Y63iPwAaxKT27sG3dhyXpf-EABXWIlgUu0FBQ3IIA5kiQDccrsIPN06nR6XBFnNeTu1ogpvhiaZsK7R-VRXcFAsrQvOc4tnzXLlTSM68gR8hBmGYZtQUoOJrRo93U1xfGf7kODnnOqUBWI3VhQIMgnl8Rtt4pl3H7IK0._jHfn0N3UQ0z_FJlv4C8jBXiadkqdO-IHWJzQ3xlm0w&dib_tag=se&keywords=M4*16mm+screw&qid=1774772422&s=industrial&sprefix=m4+16mm+screw%2Cindustrial%2C364&sr=1-9)  |
| Tornillo | Tornillo prisionero M3*8mm | 5 | 5$ | [Amazong](https://www.amazon.com/Headless-Internal-Stainless-Concave-External/dp/B0D8TGXG9D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)  |
| Tornillo | Tornillo avellanado M3*22mm | Several |  |  [Amazong](https://www.amazon.com/Countersunk-DIN7991-Stainless-Threaded-Fasteners/dp/B0CG1PV6SH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) |
| Tornillo | Tornillo avellanado M3*8mm | Several |  | [Amazong](https://www.amazon.com/Countersunk-DIN7991-Stainless-Threaded-Fasteners/dp/B0CG1PV6SH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)  |
| Tornillo | Tornillo avellanado M3*16mm | Several |  |[Amazong](https://www.amazon.com/Countersunk-DIN7991-Stainless-Threaded-Fasteners/dp/B0CG1PV6SH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) |
| Tornillo | Tornillo autorroscante M3*12mm | Several |  | [Amazong](https://www.amazon.com/Countersunk-DIN7991-Stainless-Threaded-Fasteners/dp/B0CG1PV6SH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)  |
| Pasador cilíndrico | M4*8mm | Several |  | [Amazong](https://www.amazon.com/Countersunk-DIN7991-Stainless-Threaded-Fasteners/dp/B0CG1PV6SH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)  |
| Pasador cilíndrico | M4*12mm | Several |  | [Amazong](https://www.amazon.com/Countersunk-DIN7991-Stainless-Threaded-Fasteners/dp/B0CG1PV6SH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)  |
| Juego de destornilladores | Juego de llaves hexagonales | 1 | 16$  | [Amazong](amazon.com/Amazon-Basics-Ratcheting-Electronics-Screwdriver/dp/B07V4TFWFZ/ref=sr_1_2?crid=ADAY70RZDSLN&dib=eyJ2IjoiMSJ9.jcLL4o6IXTnPlPfTTzbCZCBuZx2sLkvdUQCwlL58aq__GOyLxVPnwLI0mvGptba_HeVz6ctLQ_ziQw56BMDH9IOaw-4PVJGMktQM74mWficwggm3ckDGyAH-agN_zkB3K0_W-wrS56jfcMYFbZSWhWxr-iSOC4sdXwMGlt4rYGtenyn9yAFYBIHqjU2El5_OAKuspsrF0yQvfyfQPQHs46SClWN8zlSemGVZRuVSU26f0f9yApF6BfWHANKNNhT0Mfb6bQ8oM2XUMvwaazrrKoHeTARuoflVaVZvMU776bs.r8gy_gMINEy0qy4JyK--z-IbPZEv-SWeMGohOOE7M60&dib_tag=se&keywords=Screwdriver+set&qid=1774772499&s=industrial&sprefix=screwdriver+set+%2Cindustrial%2C374&sr=1-2)  |
|    | XT30 2+2 350mm | 2 | 4 $/cable | Ambos extremos en ángulo |
|    | XT30 2+2 350mm | 1 | 4 $/cable | Un extremo en ángulo y un extremo recto |
|    | XT30 2+2 200mm | 3 | 4 $/cable | Ambos extremos en ángulo |
| Requerido personalizado | XT30 2+2 200mm | 1 | 3 $/cable | Ambos extremos rectos |
| Sargento para carpintería | Sargento tipo G de 6 pulgadas | 2 | 20 $/unit | [Amazong](https://www.amazon.com/gp/aw/d/B092J1YW2M/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) |
| Fuente de alimentación | 24V 14.6A | 1 | 30$ | [Amazong](https://www.amazon.com/MEAN-WELL-LRS-350-24-350-4W-Switchable/dp/B013ETVO12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) |
| Cable de alimentación | 12AWG | 1 | 30 $ | [Amazong](https://www.amazon.com/Pinfox-Universal-Appliance-Replacement-Pigtail/dp/B0F5PW5SJG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) |
| Cable de alimentación | XT30 16awg | 1 | 9 $ | [Amazong](https://www.amazon.com/RioRand-Connector-Pigtail-Silicone-Aircraft/dp/B0FY2ZCR83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) |

---
