Yang-Ci/Rebot-Arm/media/v1.1_2.png

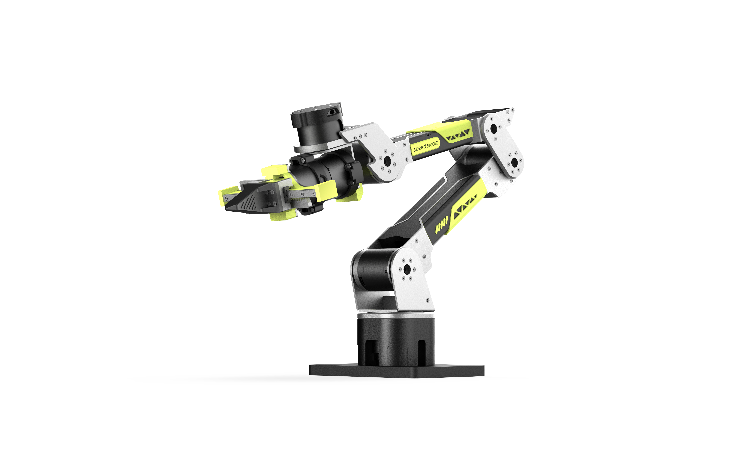
media/v1.1_2.png
