Yang-Ci/Rebot-Arm/reBotArm_simulator/analysis_report/webpage-home.png

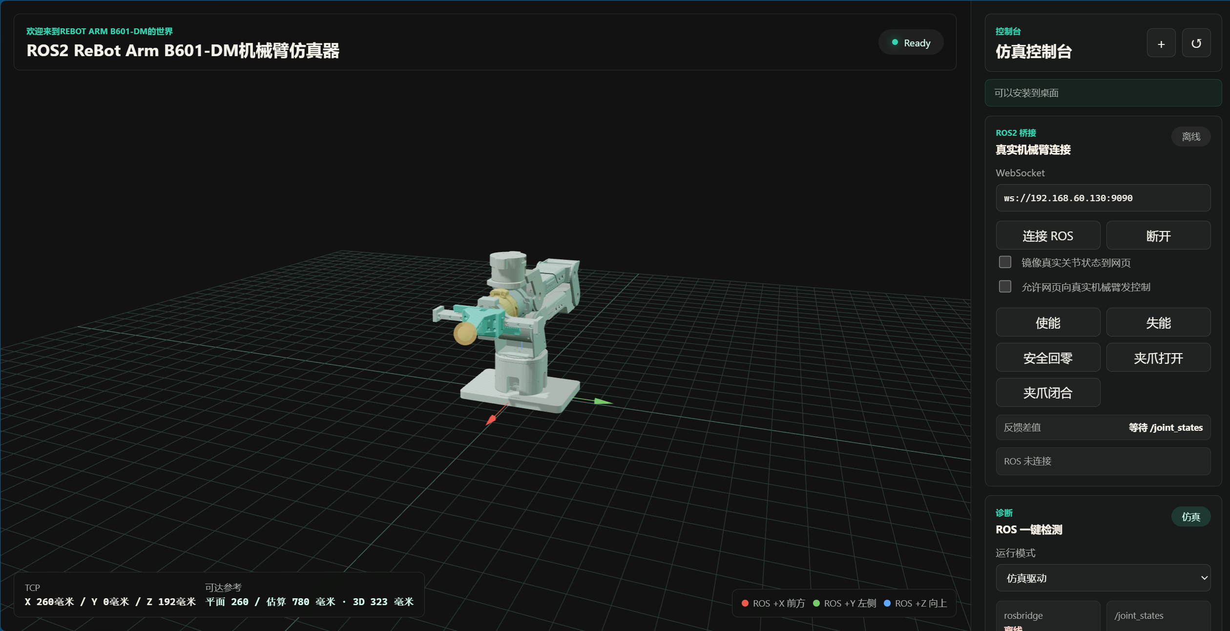
reBotArm_simulator/analysis_report/webpage-home.png
