Yang-Ci/Rebot-Arm/hardware/reBot_B601_DM/3D_Printed_Parts/01_Upper_Arm_Fuller_L.step

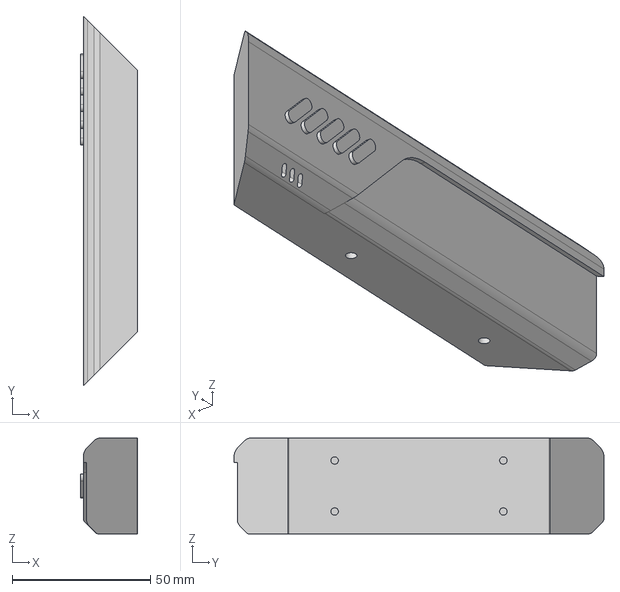
[picture p51: CAD file, 2026-06-01]
hardware/reBot_B601_DM/3D_Printed_Parts/01_Upper_Arm_Fuller_L.step
20.6 x 133.6 x 34.6 mm
