Yang-Ci/Rebot-Arm/hardware/reBot_B601_DM/3D_Printed_Parts/Soft_Gripper_Finger.step

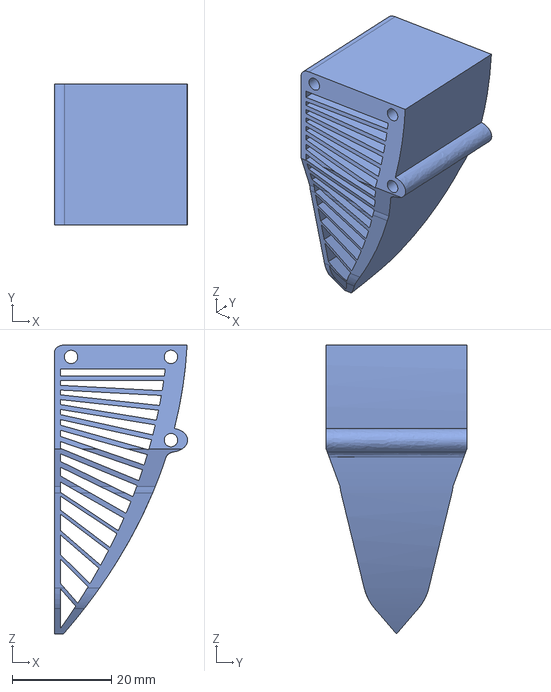
[picture p53: CAD file, 2026-06-01]
hardware/reBot_B601_DM/3D_Printed_Parts/Soft_Gripper_Finger.step
26.9 x 28.4 x 58.3 mm
