Yang-Ci/Rebot-Arm/hardware/reBot_B601_DM/Metal_Parts/02_Lower_Wrist_Link_R.step

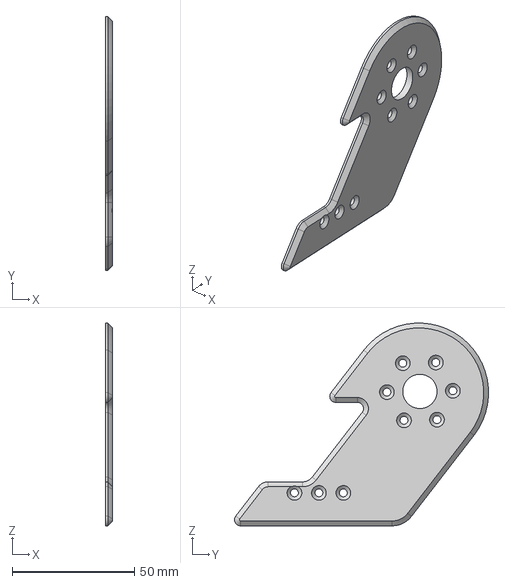
[picture p54: CAD file, 2026-06-01]
hardware/reBot_B601_DM/Metal_Parts/02_Lower_Wrist_Link_R.step
3.00 x 103.9 x 82.9 mm
