Yang-Ci/Rebot-Arm/reBotArm_simulator/split_meshes/end_link/end_link_part_16_tris_1142.stl

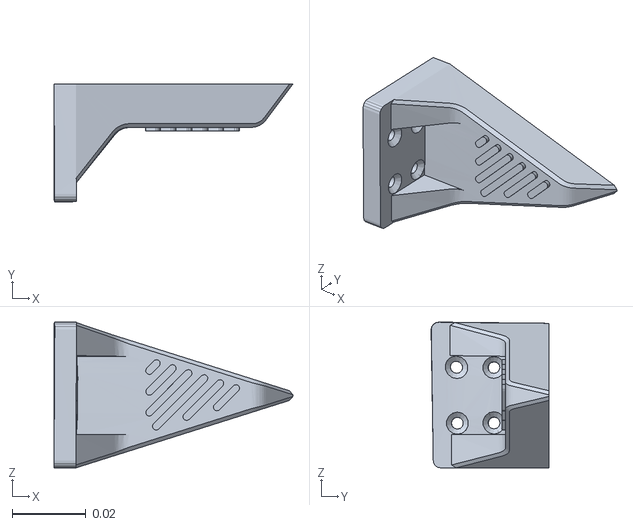
[picture p55: CAD file, 2026-06-01]
reBotArm_simulator/split_meshes/end_link/end_link_part_16_tris_1142.stl
0.0648 x 0.032 x 0.0395
