Yang-Ci/Rebot-Arm/reBotArmController_ROS2-main/src/rebotarm_bringup/description/meshes/gripper_base.stl

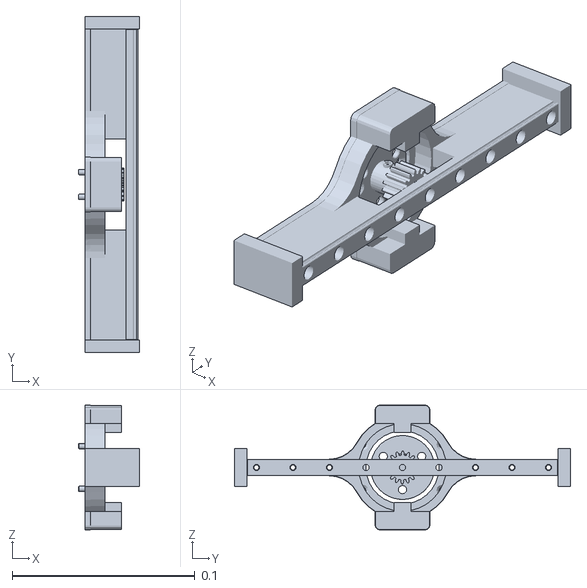
[picture p57: CAD file, 2026-06-01]
reBotArmController_ROS2-main/src/rebotarm_bringup/description/meshes/gripper_base.stl
0.0335 x 0.184 x 0.0685
