Yang-Ci/Rebot-Arm/hardware/reBot_B601_DM/3D_Printed_Parts/D435_Gemini2_Mount.step

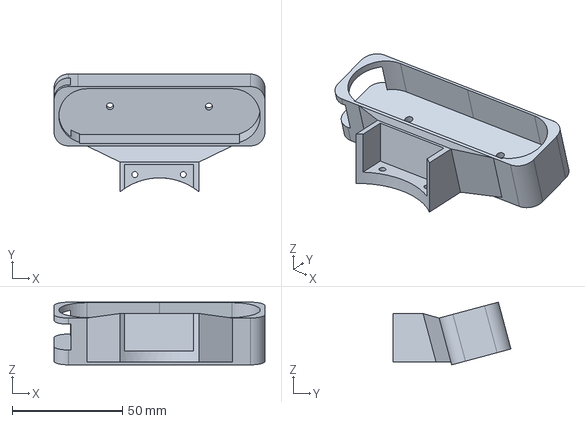
[picture p58: CAD file, 2026-06-01]
hardware/reBot_B601_DM/3D_Printed_Parts/D435_Gemini2_Mount.step
95.8 x 53.5 x 28.5 mm
