Yang-Ci/Rebot-Arm/hardware/reBot_B601_DM/Metal_Parts/03-Link1.step

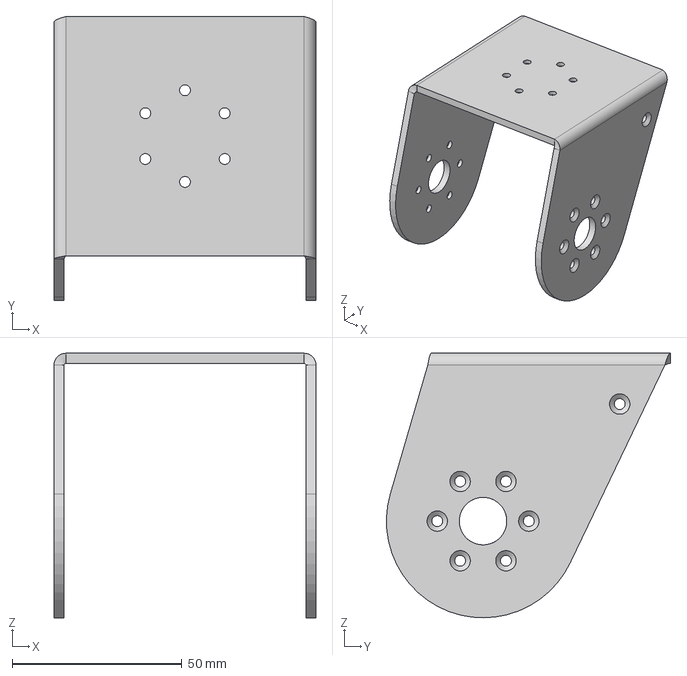
[picture p59: CAD file, 2026-06-01]
hardware/reBot_B601_DM/Metal_Parts/03-Link1.step
77.2 x 83.8 x 78.0 mm
