Yang-Ci/Rebot-Arm/reBotArm_simulator/split_meshes/grouped_gripper/gripper_hardware.stl

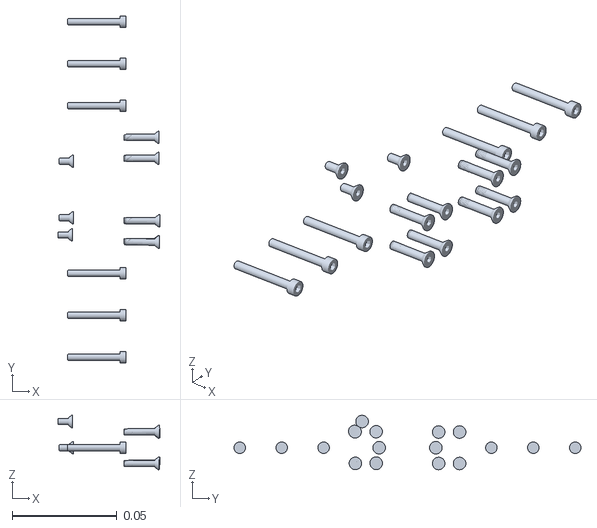
[picture p61: CAD file, 2026-06-01]
reBotArm_simulator/split_meshes/grouped_gripper/gripper_hardware.stl
0.0488 x 0.165 x 0.026
