Yang-Ci/Rebot-Arm/reBotArmController_ROS2-main/src/rebotarm_bringup/description/meshes/link6.STL

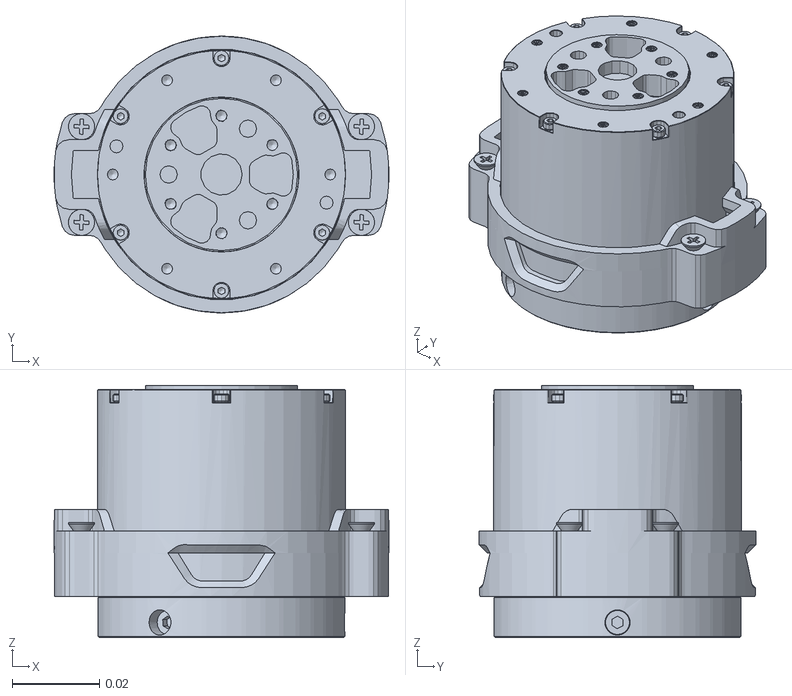
[picture p62: CAD file, 2026-06-01]
reBotArmController_ROS2-main/src/rebotarm_bringup/description/meshes/link6.STL
0.077 x 0.0636 x 0.058
