Yang-Ci/Rebot-Arm/hardware/reBot_B601_DM/3D_Printed_Parts/01_BASE_Link.step

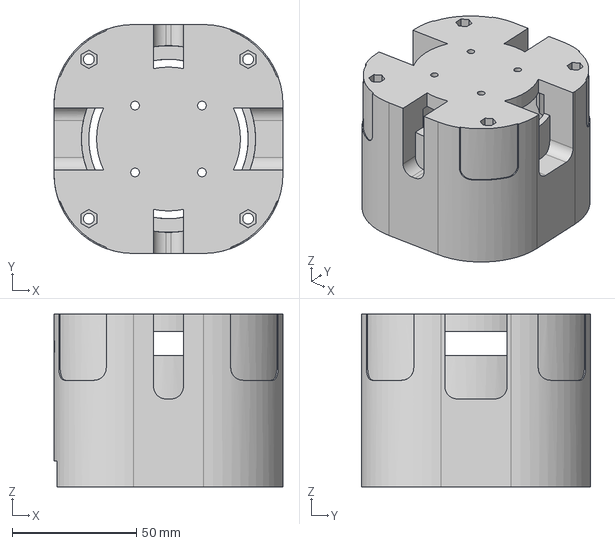
[picture p63: CAD file, 2026-06-01]
hardware/reBot_B601_DM/3D_Printed_Parts/01_BASE_Link.step
92.0 x 92.0 x 69.5 mm
