Yang-Ci/Rebot-Arm/hardware/reBot_B601_DM/Metal_Parts/02_Slider_Extension.step

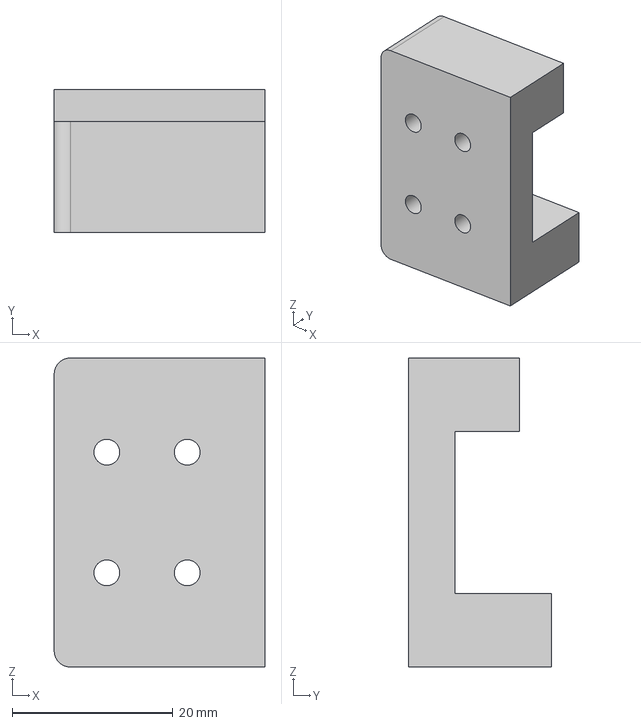
[picture p64: CAD file, 2026-06-01]
hardware/reBot_B601_DM/Metal_Parts/02_Slider_Extension.step
26.2 x 17.8 x 38.4 mm
