Yang-Ci/Rebot-Arm/reBotArm_simulator/split_meshes/end_link/end_link_part_07_tris_8614.stl

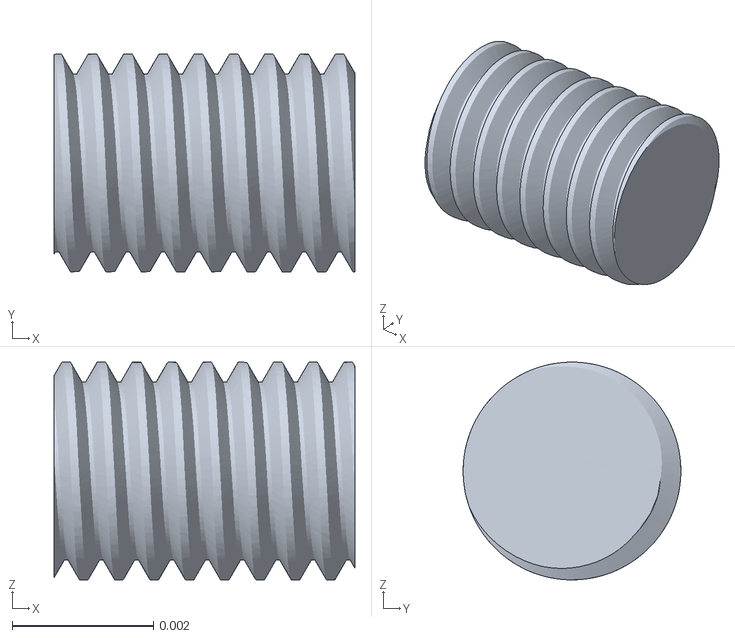
[picture p65: CAD file, 2026-06-01]
reBotArm_simulator/split_meshes/end_link/end_link_part_07_tris_8614.stl
0.00427 x 0.00309 x 0.00309
