Yang-Ci/Rebot-Arm/reBotArm_simulator/split_meshes/grouped_gripper/right_finger.stl

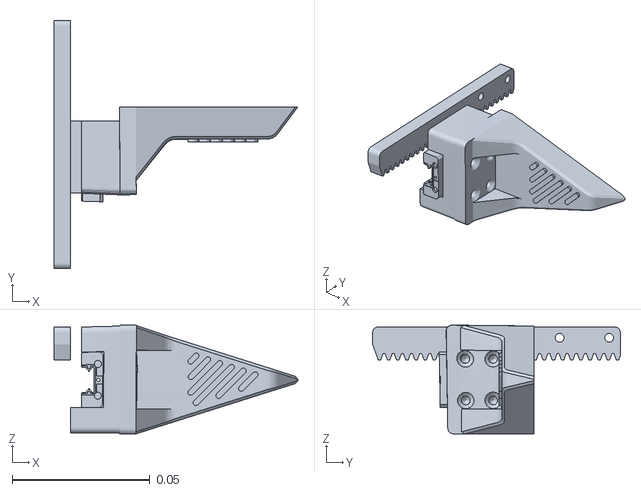
[picture p66: CAD file, 2026-06-01]
reBotArm_simulator/split_meshes/grouped_gripper/right_finger.stl
0.0886 x 0.09 x 0.0395
