Yang-Ci/Rebot-Arm/reBotArmController_ROS2-main/src/rebotarm_bringup/description/meshes/link3.STL

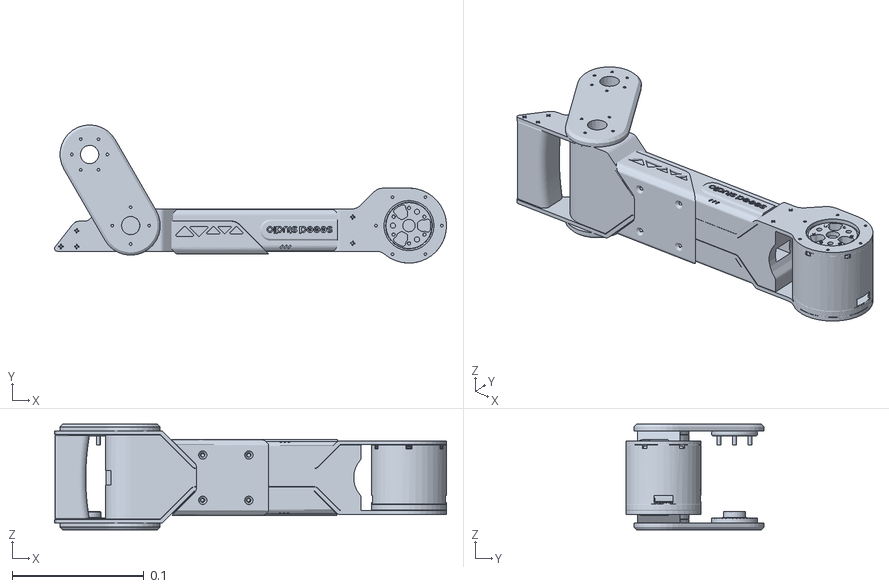
[picture p67: CAD file, 2026-06-01]
reBotArmController_ROS2-main/src/rebotarm_bringup/description/meshes/link3.STL
0.298 x 0.105 x 0.0802
