Yang-Ci/Rebot-Arm/hardware/reBot_B601_DM/Metal_Parts/03-Link3_L.step

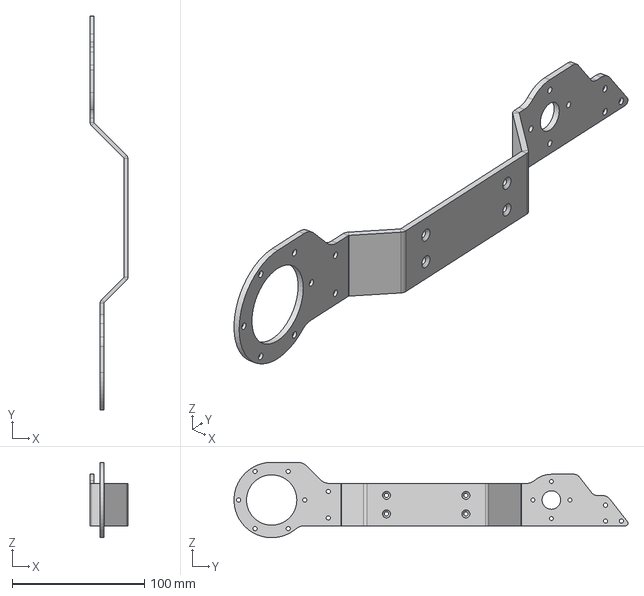
[picture p68: CAD file, 2026-06-01]
hardware/reBot_B601_DM/Metal_Parts/03-Link3_L.step
28.6 x 297.8 x 57.0 mm
