Yang-Ci/Rebot-Arm/reBotArm_simulator/split_meshes/end_link/end_link_part_22_tris_466.stl

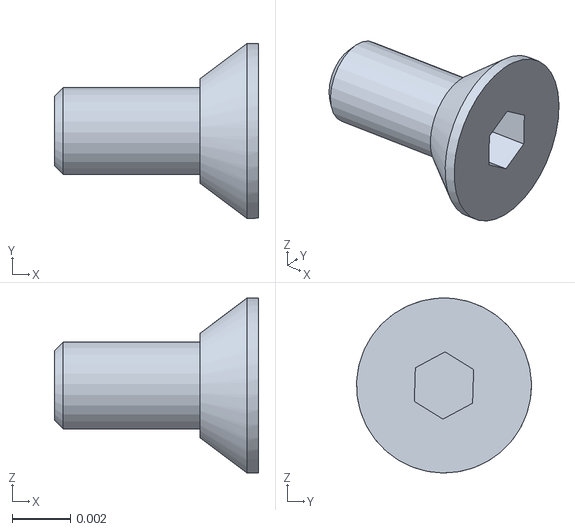
[picture p69: CAD file, 2026-06-01]
reBotArm_simulator/split_meshes/end_link/end_link_part_22_tris_466.stl
0.007 x 0.006 x 0.006
