Yang-Ci/Rebot-Arm/hardware/reBot_B601_DM/3D_Printed_Parts/UVC32_mount.step

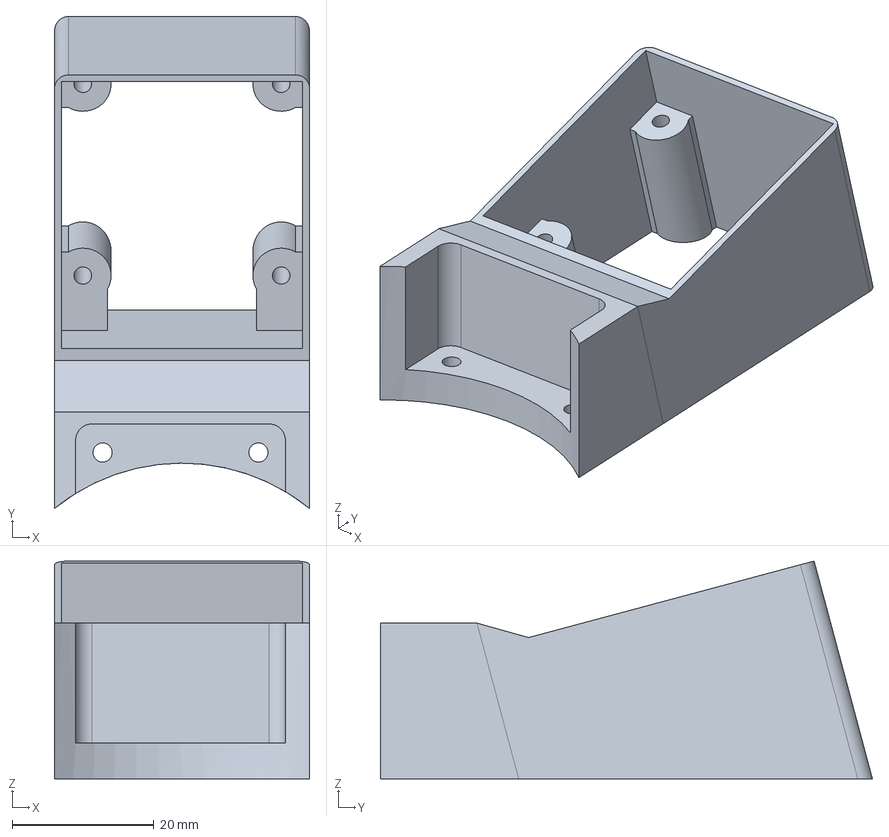
[picture p70: CAD file, 2026-06-01]
hardware/reBot_B601_DM/3D_Printed_Parts/UVC32_mount.step
36.0 x 69.4 x 30.8 mm
