Yang-Ci/Rebot-Arm/hardware/reBot_B601_DM/Metal_Parts/02_Gear_Connector.step

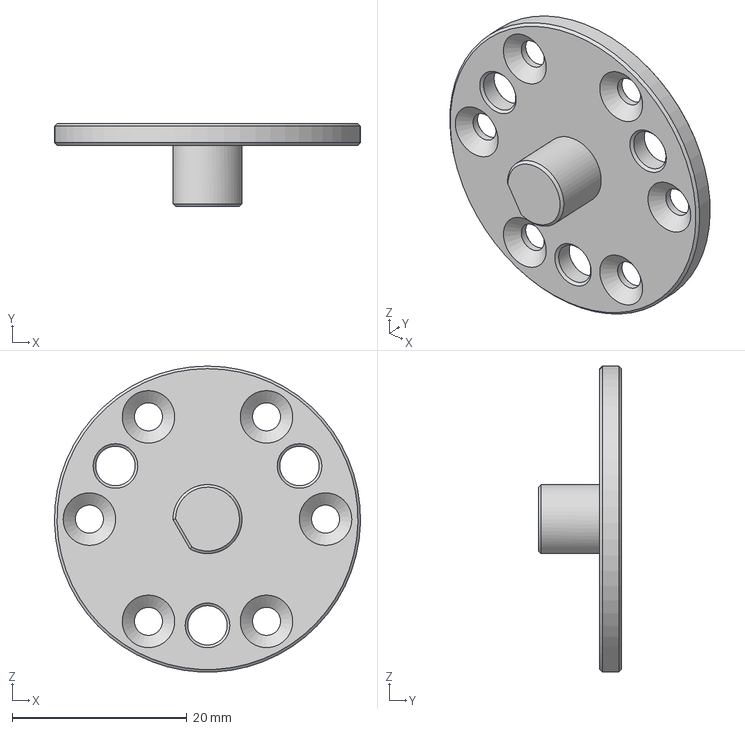
[picture p71: CAD file, 2026-06-01]
hardware/reBot_B601_DM/Metal_Parts/02_Gear_Connector.step
35.0 x 9.50 x 35.0 mm
