Yang-Ci/Rebot-Arm/reBotArm_simulator/split_meshes/end_link/end_link_part_39_tris_322.stl

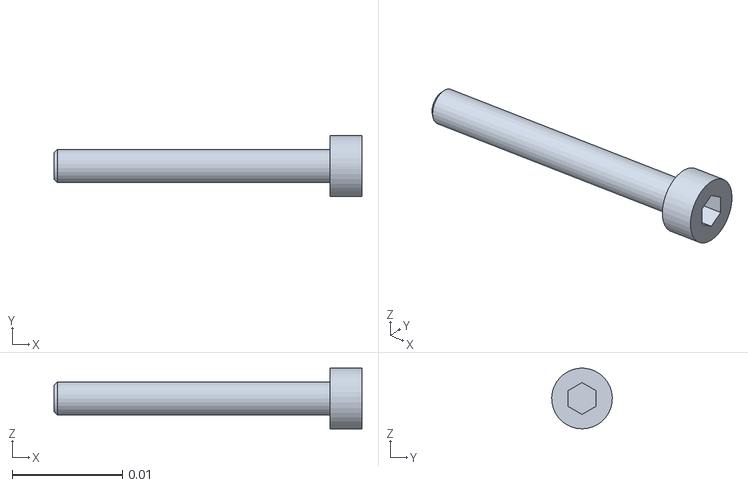
[picture p72: CAD file, 2026-06-01]
reBotArm_simulator/split_meshes/end_link/end_link_part_39_tris_322.stl
0.0279 x 0.00549 x 0.0055
