Yang-Ci/Rebot-Arm/reBotArmController_ROS2-main/src/rebotarm_bringup/description/meshes/base_link.STL

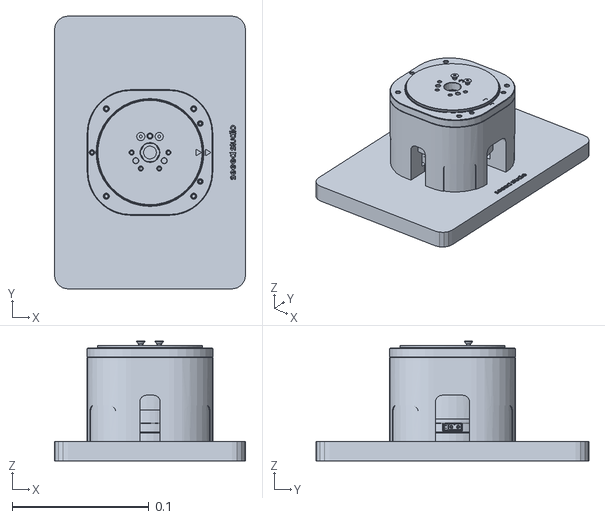
[picture p73: CAD file, 2026-06-01]
reBotArmController_ROS2-main/src/rebotarm_bringup/description/meshes/base_link.STL
0.14 x 0.2 x 0.0877
