Yang-Ci/Rebot-Arm/hardware/reBot_B601_DM/3D_Printed_Parts/01_Arm_Handle.step

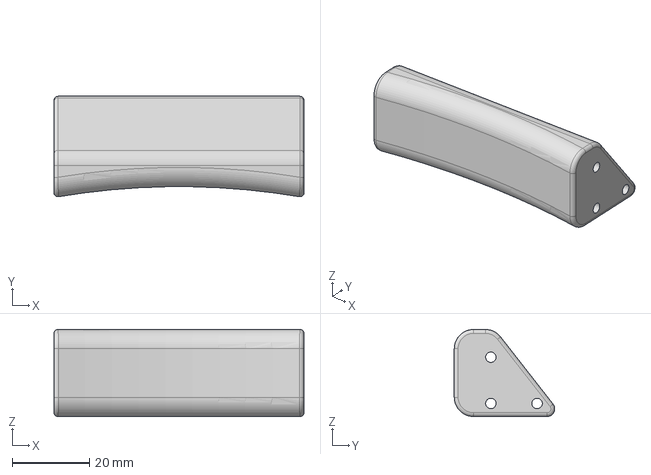
[picture p74: CAD file, 2026-06-01]
hardware/reBot_B601_DM/3D_Printed_Parts/01_Arm_Handle.step
64.8 x 26.1 x 22.6 mm
