Yang-Ci/Rebot-Arm/reBotArmController_ROS2-main/src/rebotarm_bringup/description/meshes/link1.STL

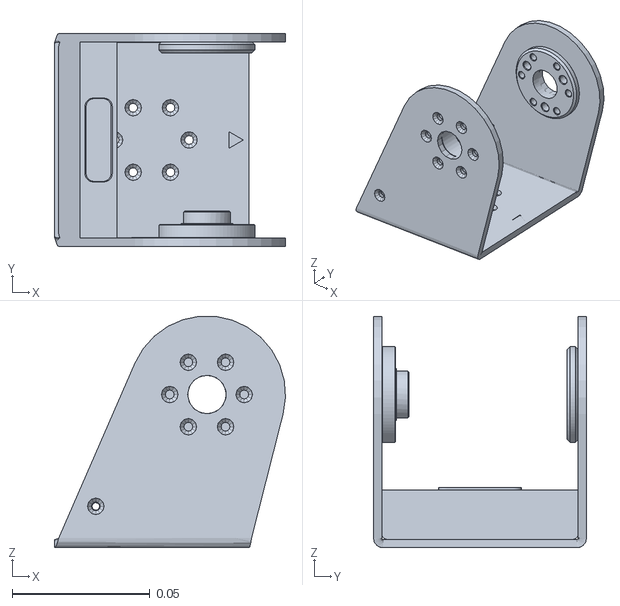
[picture p76: CAD file, 2026-06-01]
reBotArmController_ROS2-main/src/rebotarm_bringup/description/meshes/link1.STL
0.0838 x 0.0772 x 0.0839
