Yang-Ci/Rebot-Arm/hardware/reBot_B601_DM/3D_Printed_Parts/01_Joint6_7_Cable Restraint_A.step

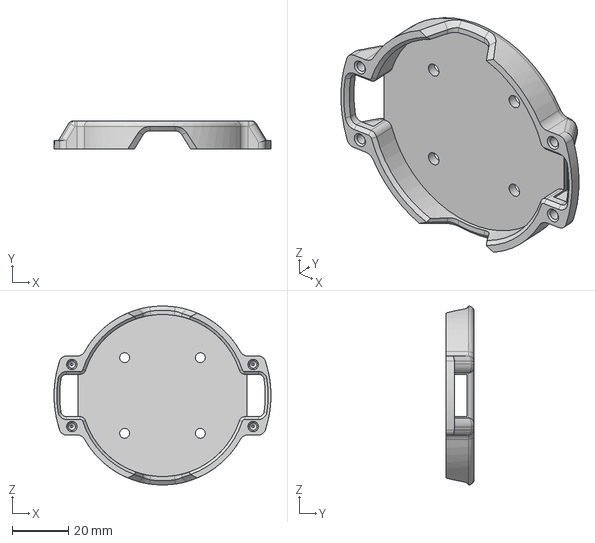
[picture p77: CAD file, 2026-06-01]
hardware/reBot_B601_DM/3D_Printed_Parts/01_Joint6_7_Cable Restraint_A.step
77.0 x 10.0 x 63.5 mm
