Yang-Ci/Rebot-Arm/hardware/reBot_B601_DM/Metal_Parts/02_Base_Motor_Shim.step

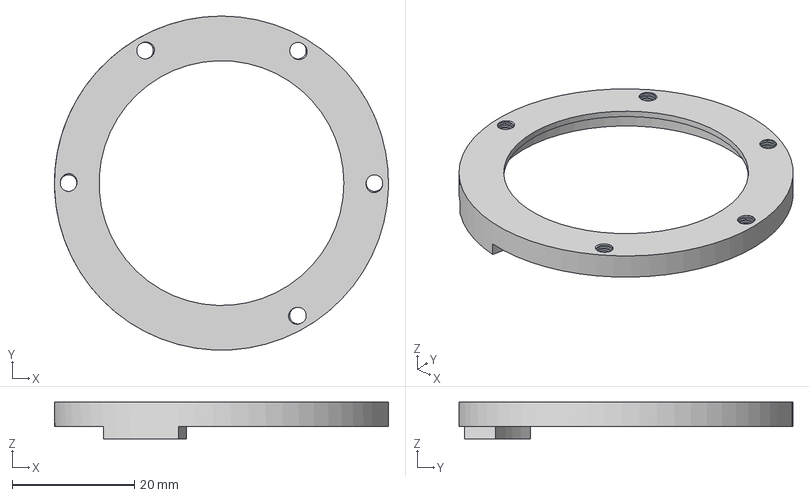
[picture p78: CAD file, 2026-06-01]
hardware/reBot_B601_DM/Metal_Parts/02_Base_Motor_Shim.step
54.6 x 54.6 x 6.00 mm
