Yang-Ci/Rebot-Arm/reBotArm_simulator/split_meshes/end_link/end_link_part_09_tris_2338.stl

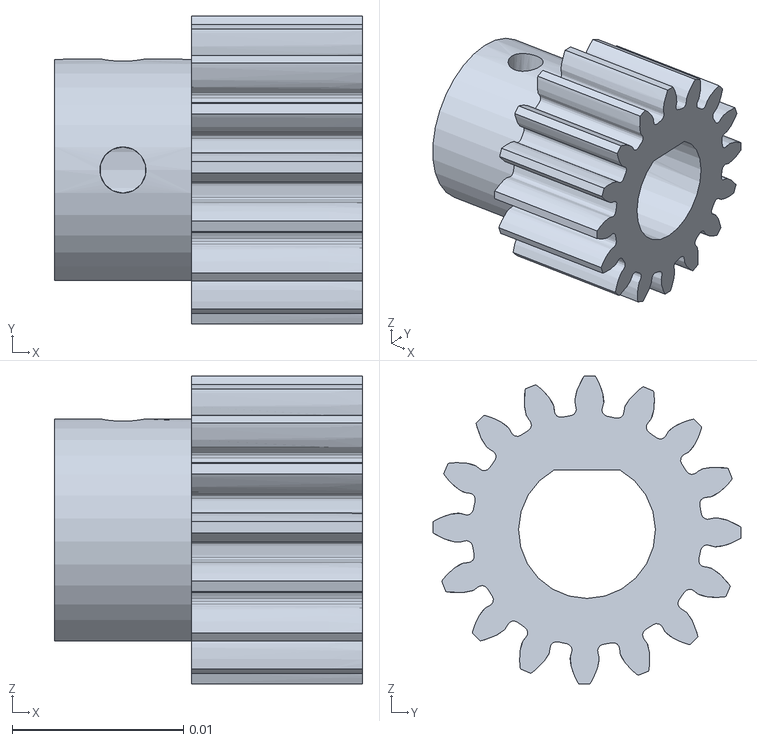
[picture p79: CAD file, 2026-06-01]
reBotArm_simulator/split_meshes/end_link/end_link_part_09_tris_2338.stl
0.018 x 0.018 x 0.018
