Yang-Ci/Rebot-Arm/hardware/reBot_B601_DM/3D_Printed_Parts/01_Lower_Arm_Limit.step

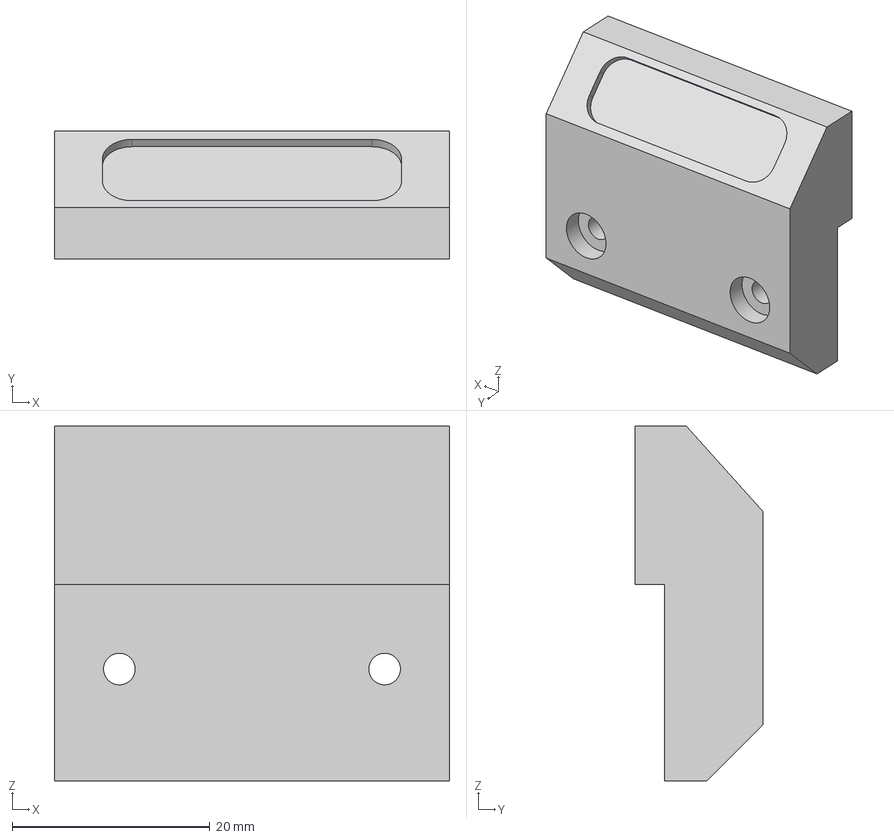
[picture p81: CAD file, 2026-06-01]
hardware/reBot_B601_DM/3D_Printed_Parts/01_Lower_Arm_Limit.step
40.0 x 13.0 x 35.9 mm
