Yang-Ci/Rebot-Arm/hardware/reBot_B601_DM/Metal_Parts/02_Motor_Back_Spacer.step

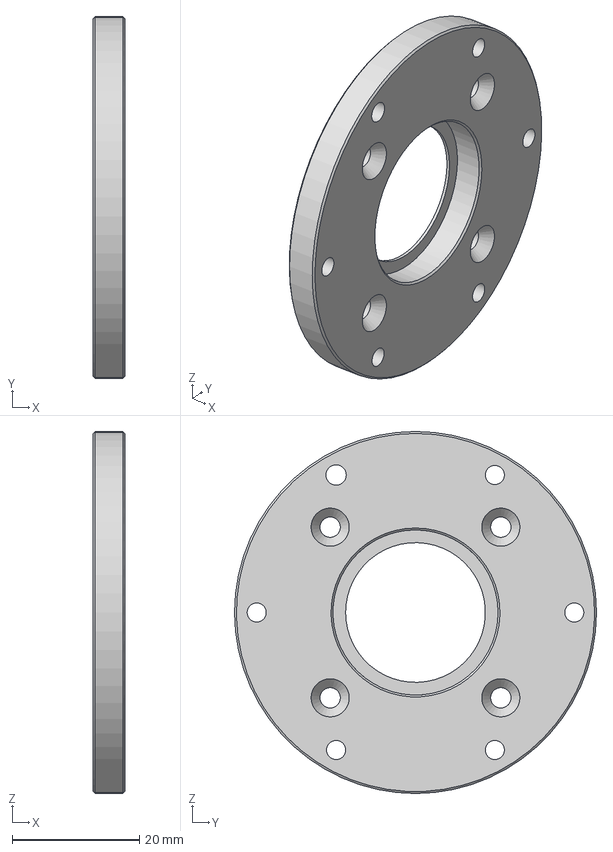
[picture p82: CAD file, 2026-06-01]
hardware/reBot_B601_DM/Metal_Parts/02_Motor_Back_Spacer.step
5.00 x 57.0 x 57.0 mm
