Yang-Ci/Rebot-Arm/hardware/reBot_B601_DM/3D_Printed_Parts/01_Lower_Arm_Filler_R.step

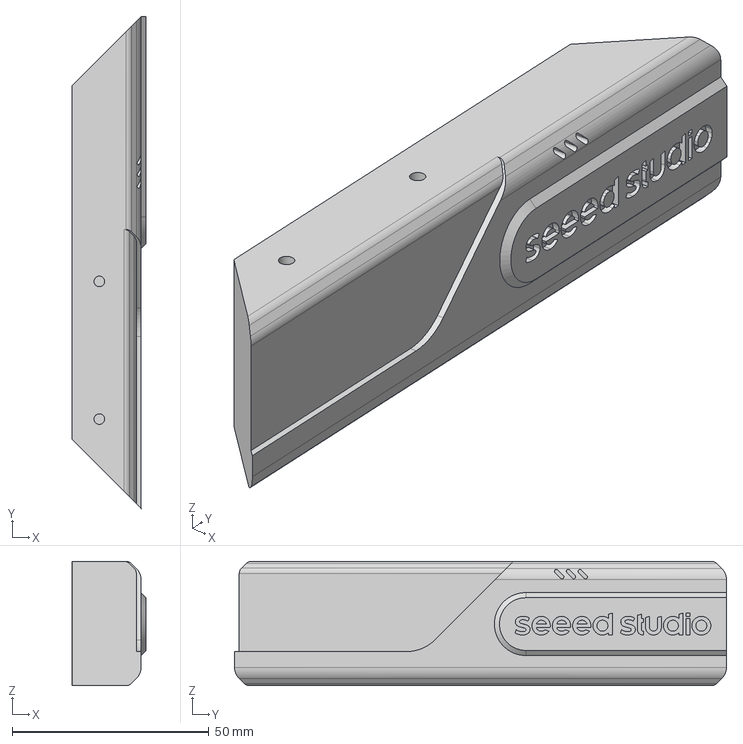
[picture p83: CAD file, 2026-06-01]
hardware/reBot_B601_DM/3D_Printed_Parts/01_Lower_Arm_Filler_R.step
18.9 x 125.0 x 31.6 mm
