Yang-Ci/Rebot-Arm/hardware/reBot_B601_DM/Metal_Parts/03-Link5.step

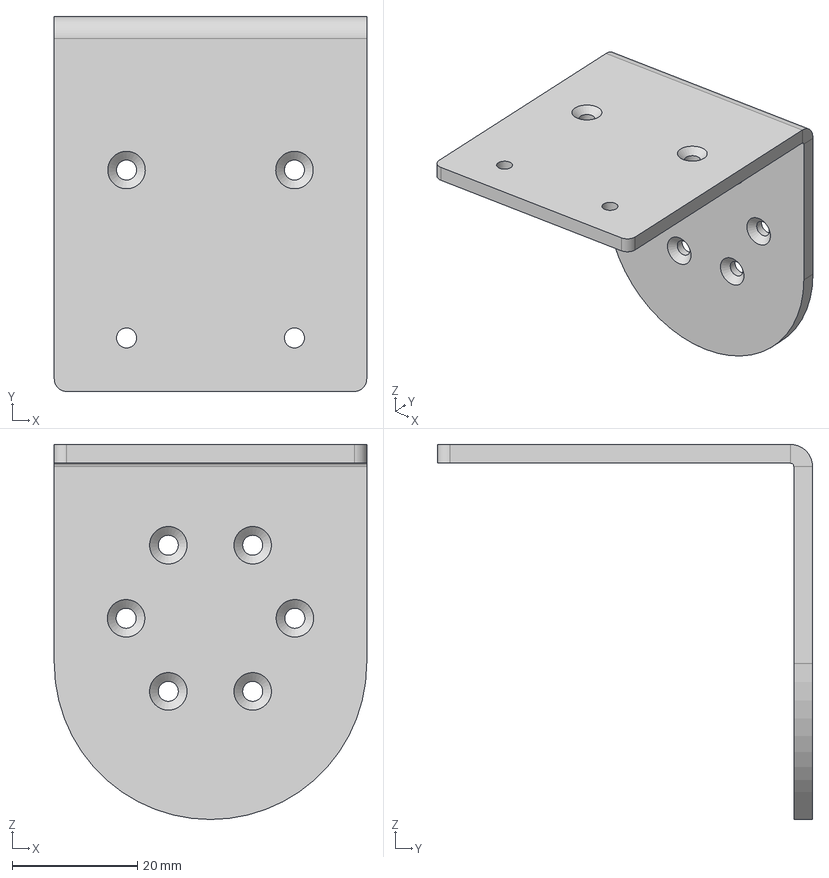
[picture p84: CAD file, 2026-06-01]
hardware/reBot_B601_DM/Metal_Parts/03-Link5.step
50.0 x 60.0 x 60.0 mm
