Yang-Ci/Rebot-Arm/reBotArm_simulator/split_meshes/end_link/end_link_part_15_tris_1142.stl

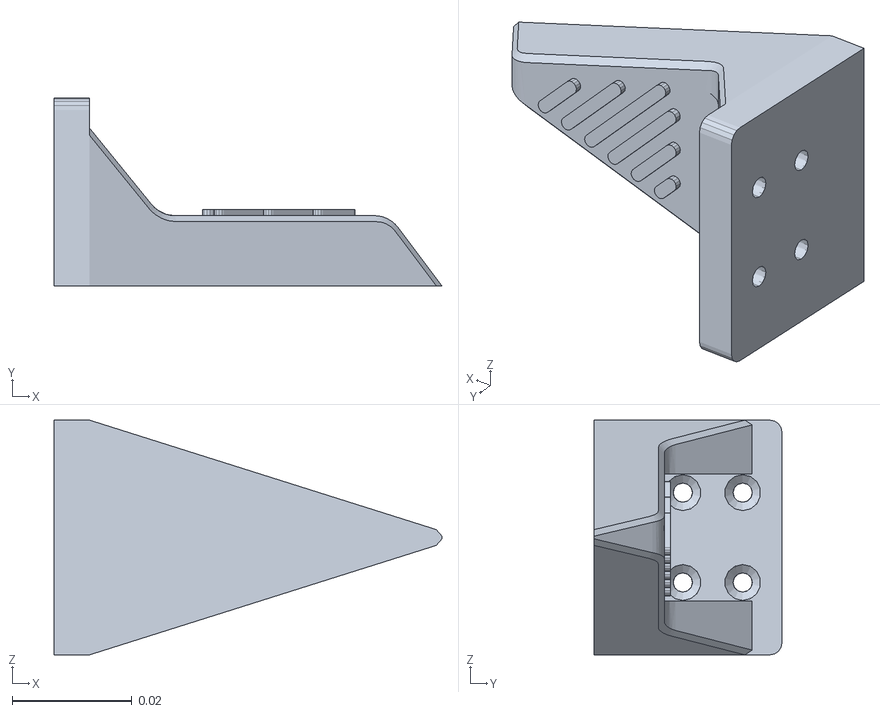
[picture p85: CAD file, 2026-06-01]
reBotArm_simulator/split_meshes/end_link/end_link_part_15_tris_1142.stl
0.0648 x 0.0314 x 0.0392
