Yang-Ci/Rebot-Arm/hardware/reBot_B601_DM/Metal_Parts/02_Lower_Upper_Link_R.step

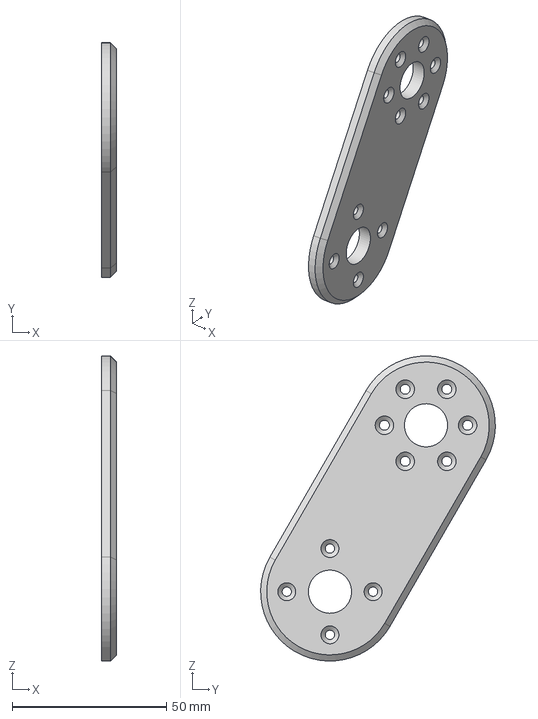
[picture p88: CAD file, 2026-06-01]
hardware/reBot_B601_DM/Metal_Parts/02_Lower_Upper_Link_R.step
5.00 x 76.1 x 99.0 mm
