Yang-Ci/Rebot-Arm/reBotArm_simulator/split_meshes/end_link/end_link_part_13_tris_2148.stl

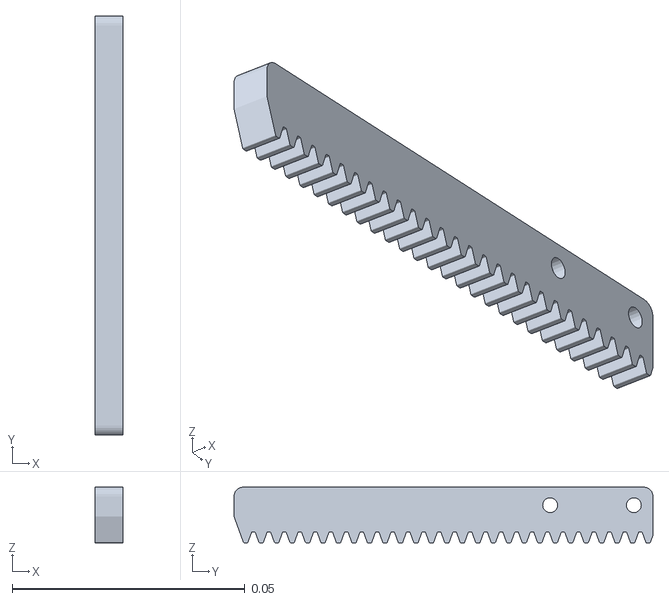
[picture p89: CAD file, 2026-06-01]
reBotArm_simulator/split_meshes/end_link/end_link_part_13_tris_2148.stl
0.006 x 0.09 x 0.012
