Yang-Ci/Rebot-Arm/hardware/reBot_B601_DM/Metal_Parts/02_Gripper_Connector_B.step

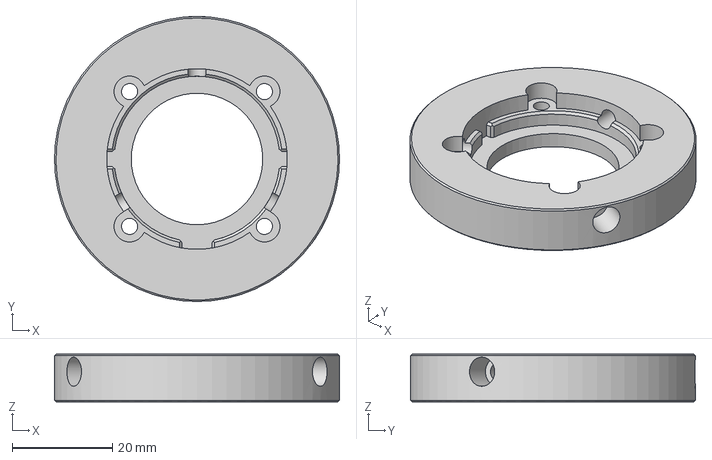
[picture p91: CAD file, 2026-06-01]
hardware/reBot_B601_DM/Metal_Parts/02_Gripper_Connector_B.step
56.8 x 56.8 x 9.50 mm
