Yang-Ci/Rebot-Arm/hardware/reBot_B601_DM/3D_Printed_Parts/01_Lower_Arm_Cover.step

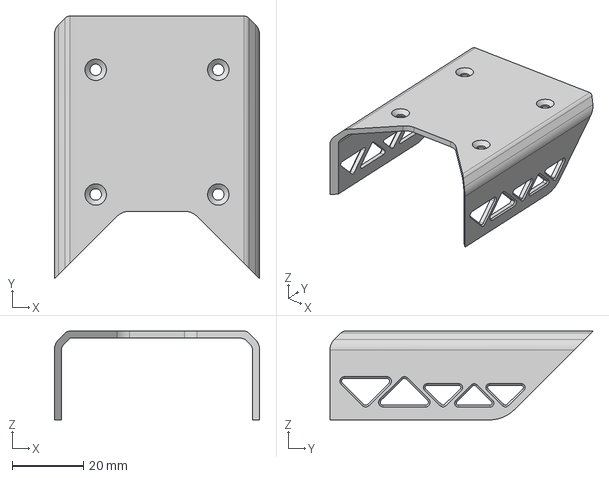
[picture p92: CAD file, 2026-06-01]
hardware/reBot_B601_DM/3D_Printed_Parts/01_Lower_Arm_Cover.step
57.6 x 73.8 x 24.9 mm
