Yang-Ci/Rebot-Arm/reBotArm_simulator/split_meshes/end_link/end_link_part_10_tris_2212.stl

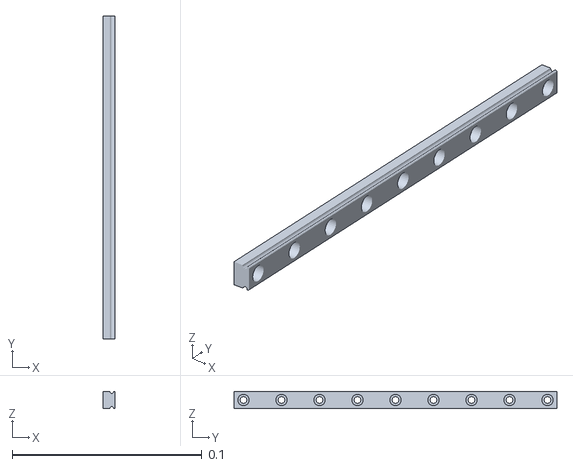
[picture p93: CAD file, 2026-06-01]
reBotArm_simulator/split_meshes/end_link/end_link_part_10_tris_2212.stl
0.0065 x 0.17 x 0.009
