Yang-Ci/Rebot-Arm/hardware/reBot_B601_DM/Metal_Parts/02_Arm_Yaw_Limit.step

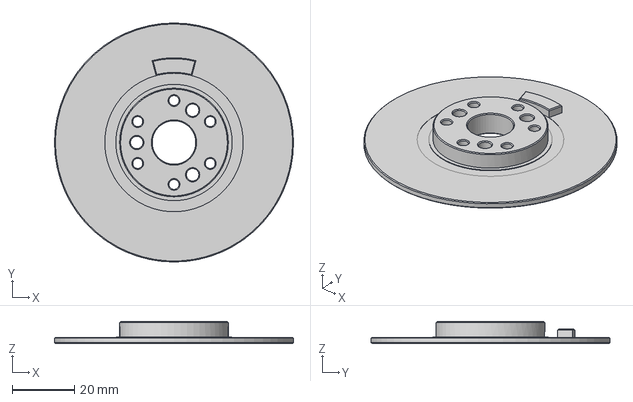
[picture p95: CAD file, 2026-06-01]
hardware/reBot_B601_DM/Metal_Parts/02_Arm_Yaw_Limit.step
77.0 x 77.0 x 7.10 mm
