Yang-Ci/Rebot-Arm/reBotArm_simulator/split_meshes/end_link/end_link_part_44_tris_310.stl

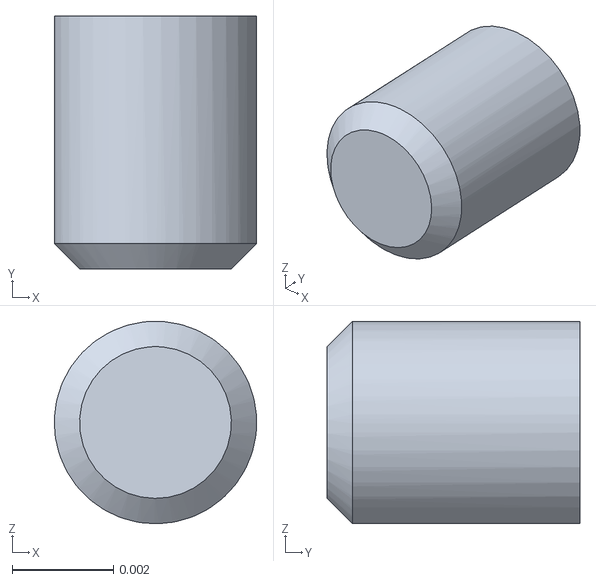
[picture p96: CAD file, 2026-06-01]
reBotArm_simulator/split_meshes/end_link/end_link_part_44_tris_310.stl
0.004 x 0.005 x 0.004
