Yang-Ci/Rebot-Arm/hardware/reBot_B601_DM/3D_Printed_Parts/01-Rail-Bracket.step

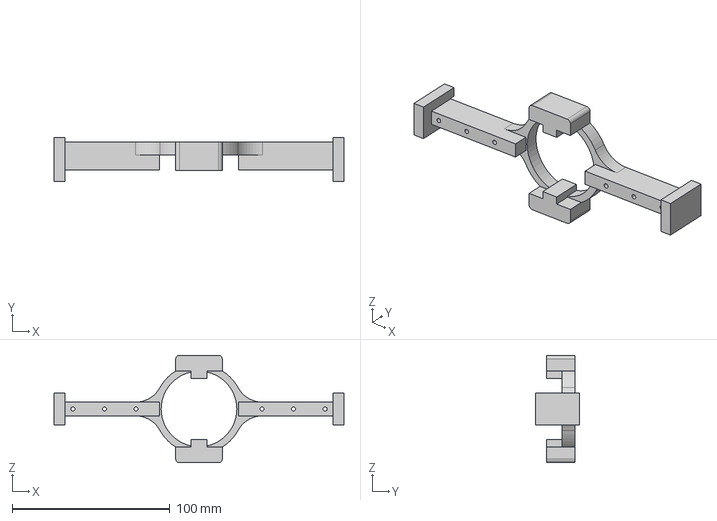
[picture p97: CAD file, 2026-06-01]
hardware/reBot_B601_DM/3D_Printed_Parts/01-Rail-Bracket.step
184.1 x 28.0 x 68.1 mm
