Yang-Ci/Rebot-Arm/hardware/reBot_B601_DM/Metal_Parts/02_Base_Reinforcement_Part.step

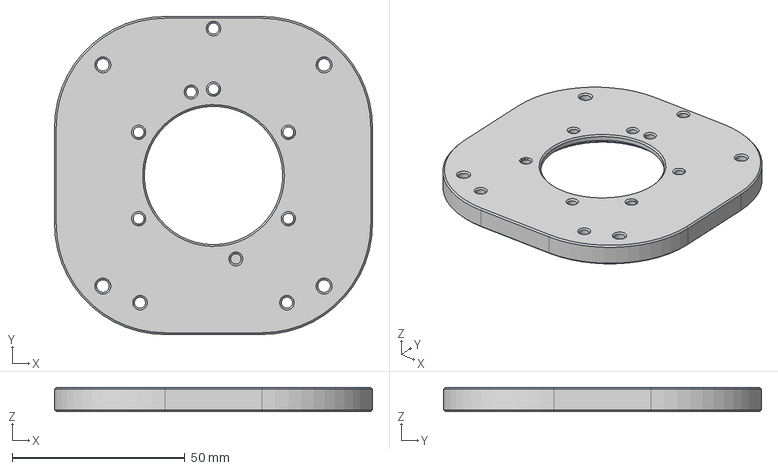
[picture p98: CAD file, 2026-06-01]
hardware/reBot_B601_DM/Metal_Parts/02_Base_Reinforcement_Part.step
92.0 x 92.0 x 6.95 mm
