Yang-Ci/Rebot-Arm/hardware/reBot_B601_DM/Metal_Parts/02_FLANGE.step

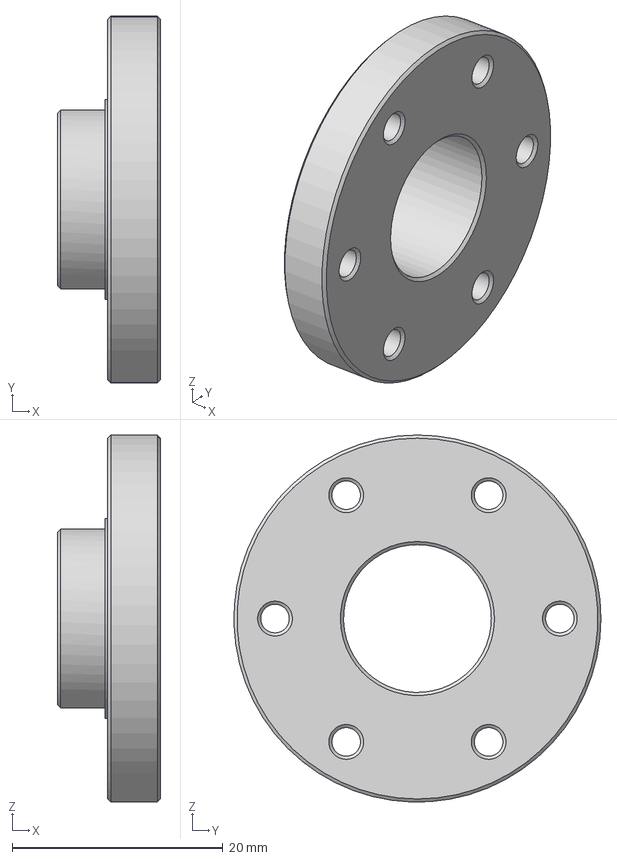
[picture p99: CAD file, 2026-06-01]
hardware/reBot_B601_DM/Metal_Parts/02_FLANGE.step
9.75 x 34.8 x 34.8 mm
