Yang-Ci/Rebot-Arm/hardware/reBot_B601_DM/3D_Printed_Parts/01_Joint6_7_Cable Restraint_B.step

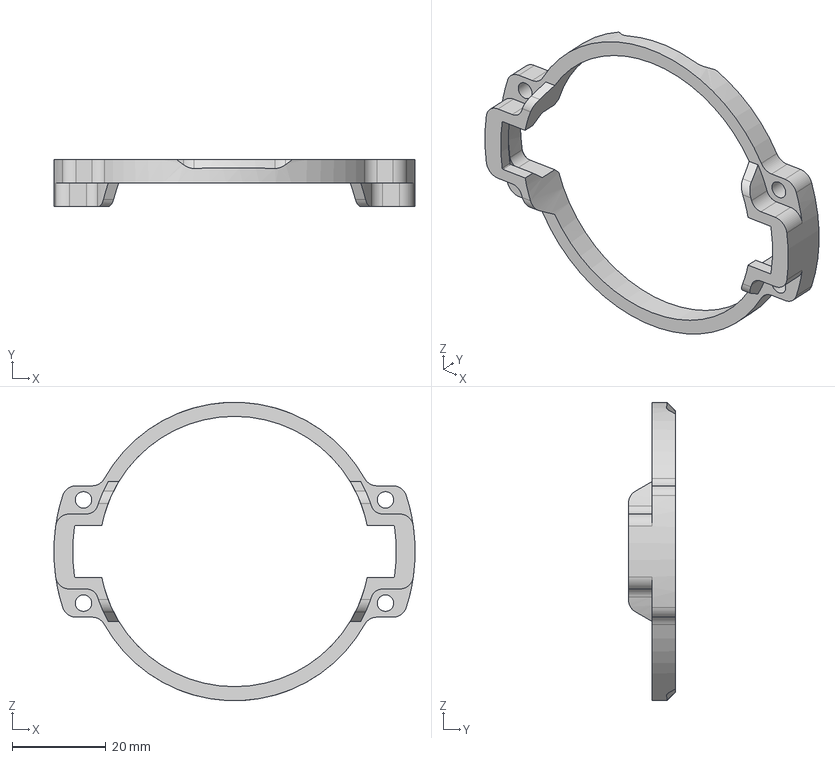
[picture p100: CAD file, 2026-06-01]
hardware/reBot_B601_DM/3D_Printed_Parts/01_Joint6_7_Cable Restraint_B.step
76.9 x 10.0 x 63.6 mm
