Yang-Ci/Rebot-Arm/hardware/reBot_B601_DM/Metal_Parts/02-RACK.step

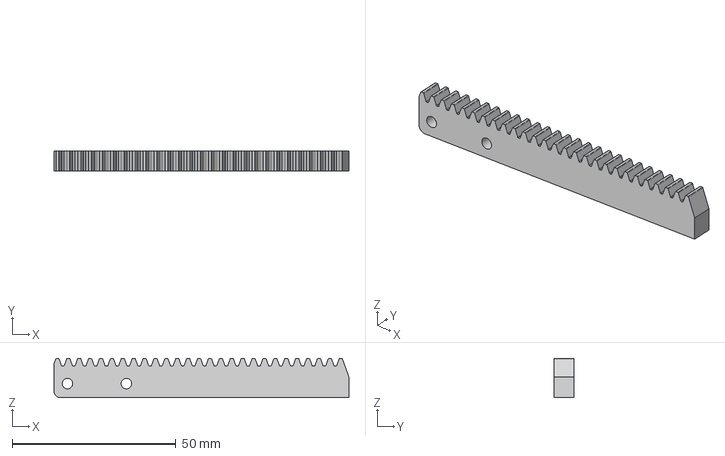
[picture p101: CAD file, 2026-06-01]
hardware/reBot_B601_DM/Metal_Parts/02-RACK.step
90.0 x 6.00 x 12.0 mm
