Yang-Ci/Rebot-Arm/reBotArm_simulator/split_meshes/end_link/end_link_part_21_tris_466.stl

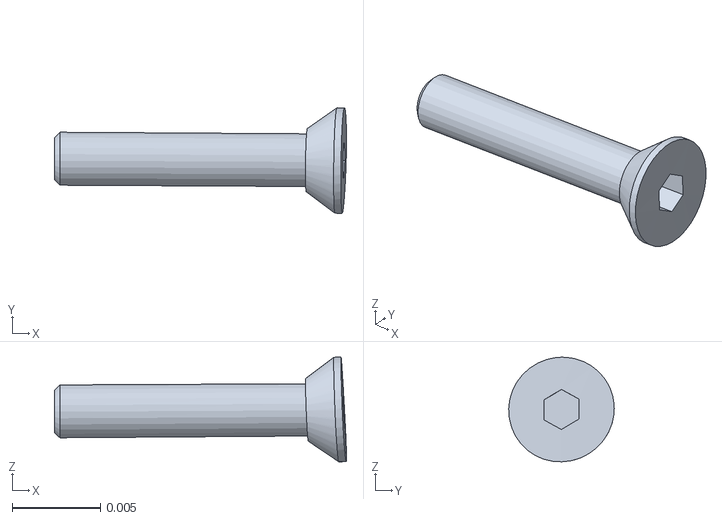
[picture p102: CAD file, 2026-06-01]
reBotArm_simulator/split_meshes/end_link/end_link_part_21_tris_466.stl
0.0165 x 0.00597 x 0.00592
