Yang-Ci/Rebot-Arm/hardware/reBot_B601_DM/3D_Printed_Parts/01_Finger.step

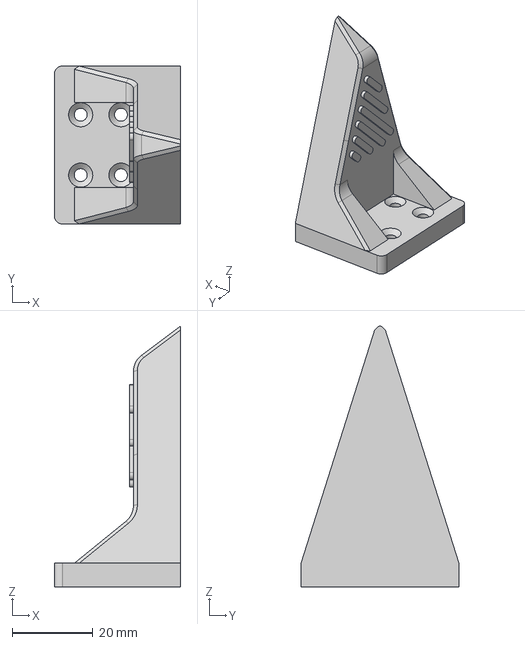
[picture p103: CAD file, 2026-06-01]
hardware/reBot_B601_DM/3D_Printed_Parts/01_Finger.step
31.4 x 39.2 x 64.8 mm
