Yang-Ci/Rebot-Arm/hardware/reBot_B601_DM/Metal_Parts/03-Link2.step

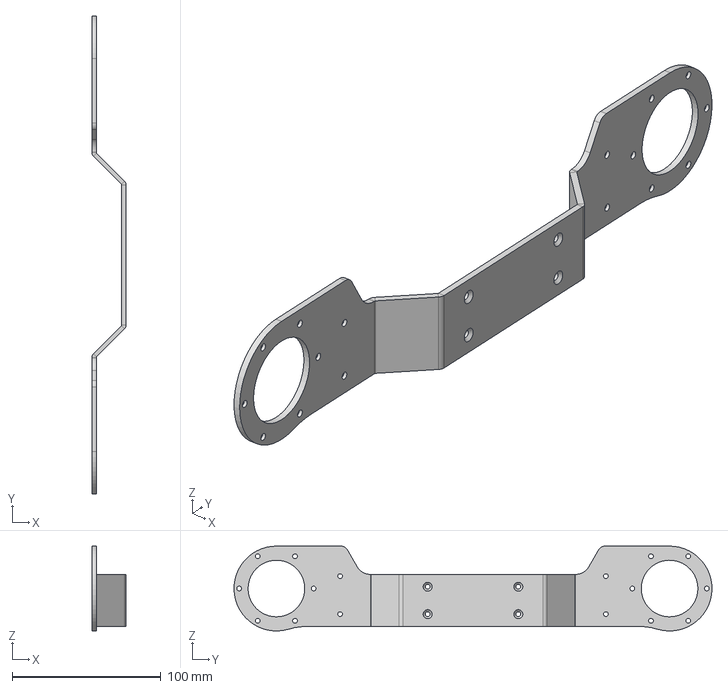
[picture p104: CAD file, 2026-06-01]
hardware/reBot_B601_DM/Metal_Parts/03-Link2.step
23.0 x 321.0 x 57.0 mm
