Yang-Ci/Rebot-Arm/hardware/reBot_B601_DM/3D_Printed_Parts/01_Motor_Cover.step

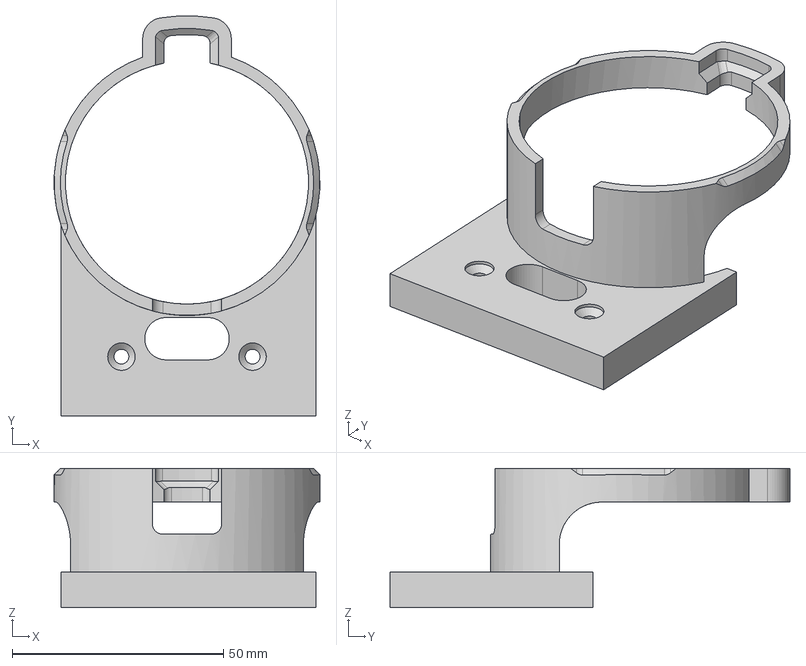
[picture p105: CAD file, 2026-06-01]
hardware/reBot_B601_DM/3D_Printed_Parts/01_Motor_Cover.step
62.9 x 94.8 x 33.0 mm
