Yang-Ci/Rebot-Arm/hardware/reBot_B601_DM/Metal_Parts/02_Slider_Bracket.step

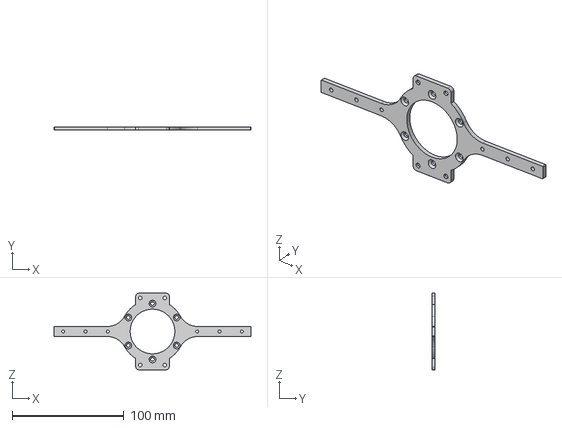
[picture p106: CAD file, 2026-06-01]
hardware/reBot_B601_DM/Metal_Parts/02_Slider_Bracket.step
176.3 x 3.00 x 68.5 mm
