Yang-Ci/Rebot-Arm/reBotArm_simulator/split_meshes/end_link/end_link_part_35_tris_400.stl

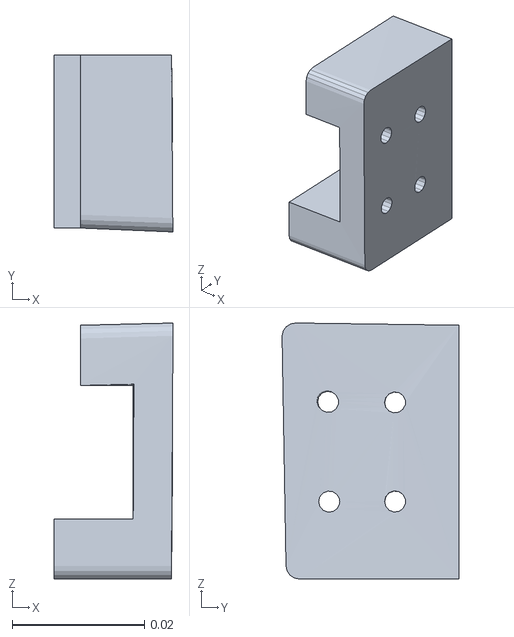
[picture p107: CAD file, 2026-06-01]
reBotArm_simulator/split_meshes/end_link/end_link_part_35_tris_400.stl
0.018 x 0.0268 x 0.0388
