Yang-Ci/Rebot-Arm/hardware/reBot_B601_DM/3D_Printed_Parts/01_Lower_Arm_Filler_M.step

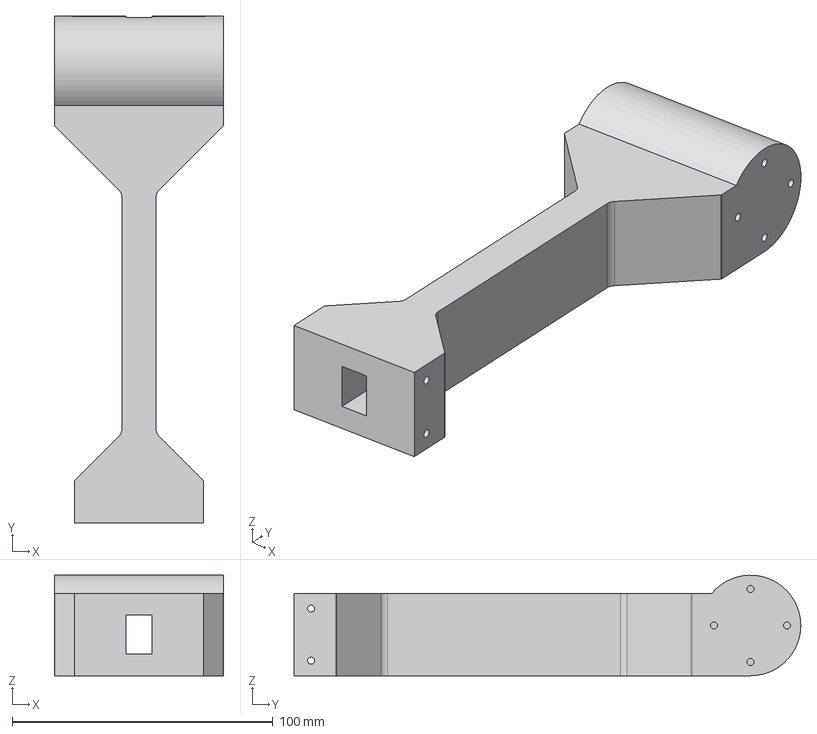
[picture p108: CAD file, 2026-06-01]
hardware/reBot_B601_DM/3D_Printed_Parts/01_Lower_Arm_Filler_M.step
64.8 x 194.4 x 38.6 mm
