Yang-Ci/Rebot-Arm/reBotArm_simulator/split_meshes/end_link/end_link_part_05_tris_8706.stl

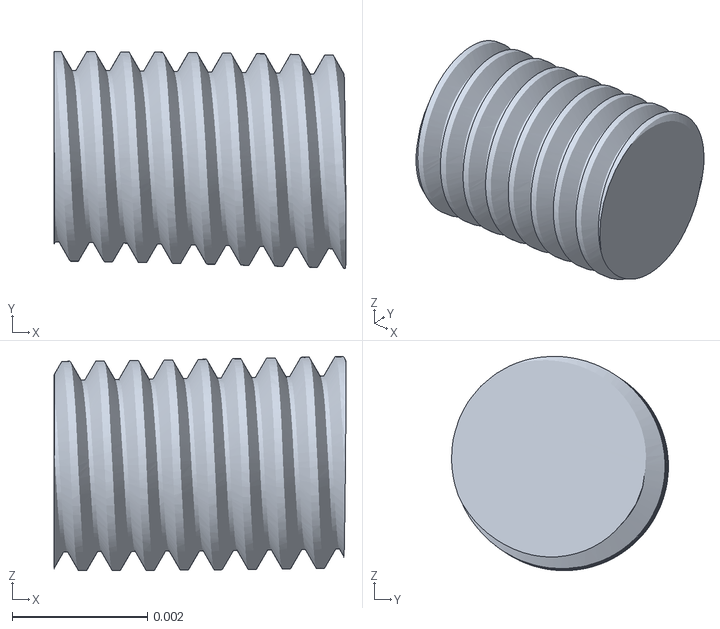
[picture p109: CAD file, 2026-06-01]
reBotArm_simulator/split_meshes/end_link/end_link_part_05_tris_8706.stl
0.00432 x 0.00321 x 0.00317
