Yang-Ci/Rebot-Arm/hardware/reBot_B601_DM/3D_Printed_Parts/01_Joint5_Cable Restraint_A.step

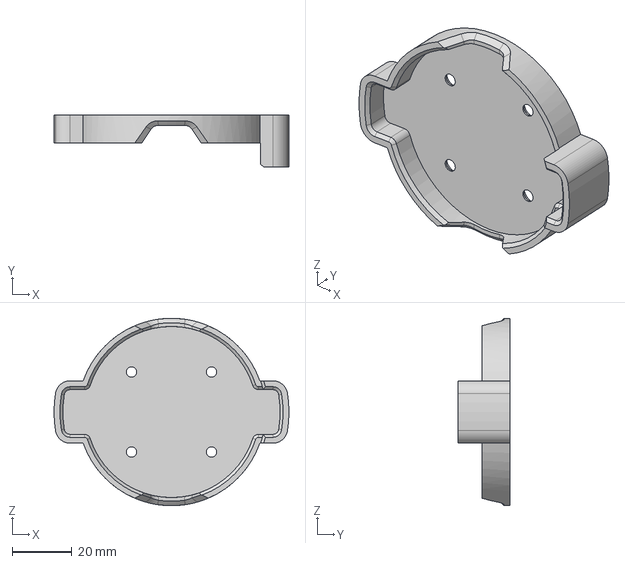
[picture p110: CAD file, 2026-06-01]
hardware/reBot_B601_DM/3D_Printed_Parts/01_Joint5_Cable Restraint_A.step
79.0 x 17.5 x 63.0 mm
