Yang-Ci/Rebot-Arm/hardware/reBot_B601_DM/Metal_Parts/02_Wrist_Bracket.step

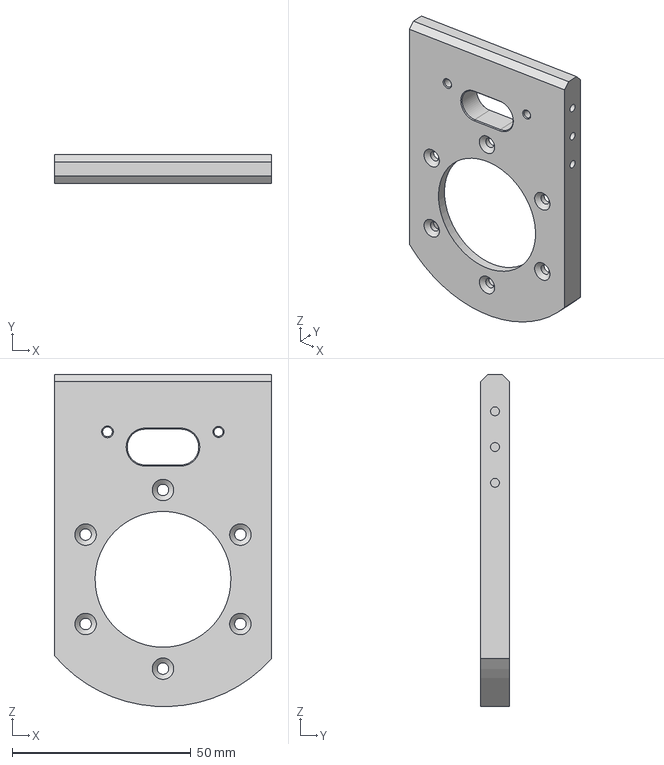
[picture p111: CAD file, 2026-06-01]
hardware/reBot_B601_DM/Metal_Parts/02_Wrist_Bracket.step
60.8 x 8.00 x 92.9 mm
