Yang-Ci/Rebot-Arm/hardware/reBot_B601_DM/3D_Printed_Parts/01_BASE_Plate.step

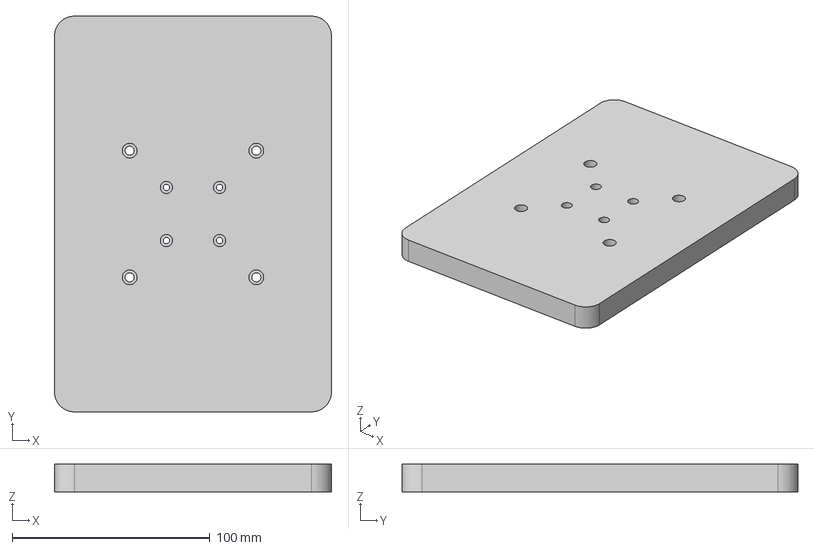
[picture p112: CAD file, 2026-06-01]
hardware/reBot_B601_DM/3D_Printed_Parts/01_BASE_Plate.step
140.0 x 200.0 x 14.0 mm
