Yang-Ci/Rebot-Arm/hardware/reBot_B601_DM/3D_Printed_Parts/Soft_Gripper_Mount.step

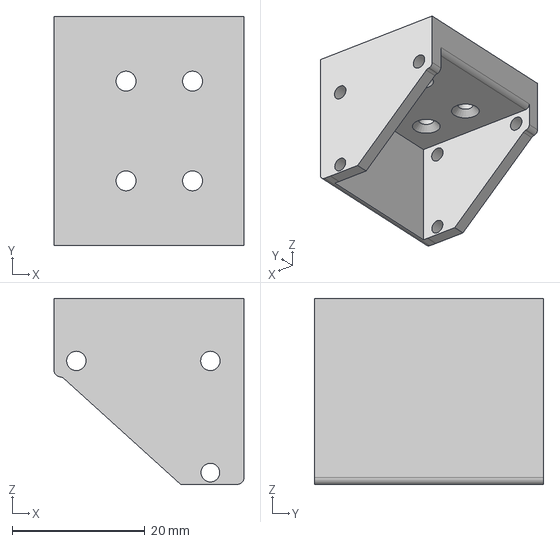
[picture p113: CAD file, 2026-06-01]
hardware/reBot_B601_DM/3D_Printed_Parts/Soft_Gripper_Mount.step
28.6 x 34.5 x 28.0 mm
