Yang-Ci/Rebot-Arm/reBotArm_simulator/split_meshes/end_link/end_link_part_36_tris_400.stl

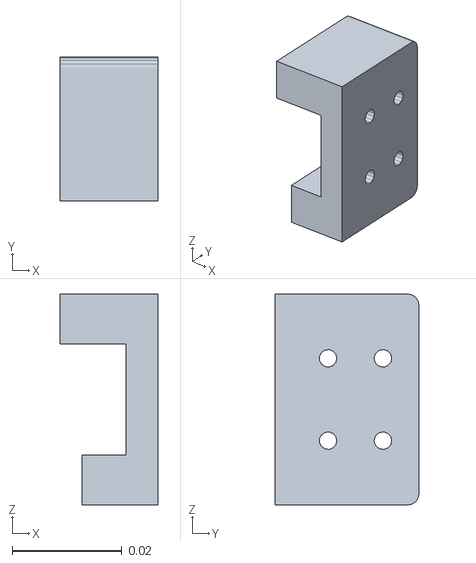
[picture p114: CAD file, 2026-06-01]
reBotArm_simulator/split_meshes/end_link/end_link_part_36_tris_400.stl
0.0178 x 0.0262 x 0.0384
