Yang-Ci/Rebot-Arm/reBotArm_simulator/split_meshes/end_link/end_link_part_11_tris_2184.stl

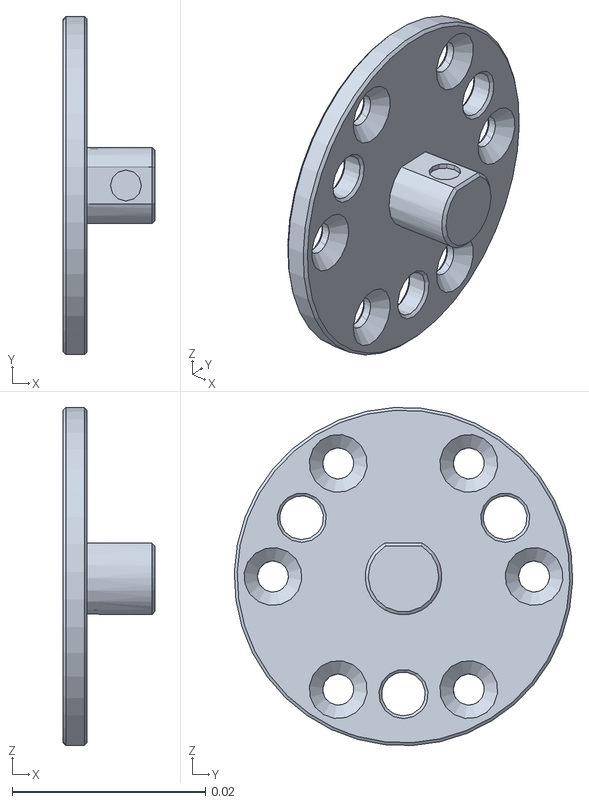
[picture p115: CAD file, 2026-06-01]
reBotArm_simulator/split_meshes/end_link/end_link_part_11_tris_2184.stl
0.0095 x 0.035 x 0.0349
