Yang-Ci/Rebot-Arm/reBotArm_simulator/split_meshes/end_link/end_link_part_19_tris_1018.stl

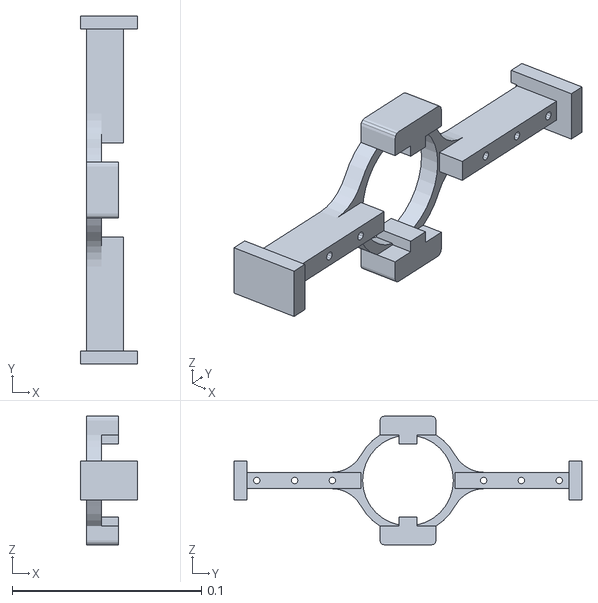
[picture p116: CAD file, 2026-06-01]
reBotArm_simulator/split_meshes/end_link/end_link_part_19_tris_1018.stl
0.03 x 0.184 x 0.0681
