Yang-Ci/Rebot-Arm/reBotArm_simulator/split_meshes/end_link/end_link_part_18_tris_1080.stl

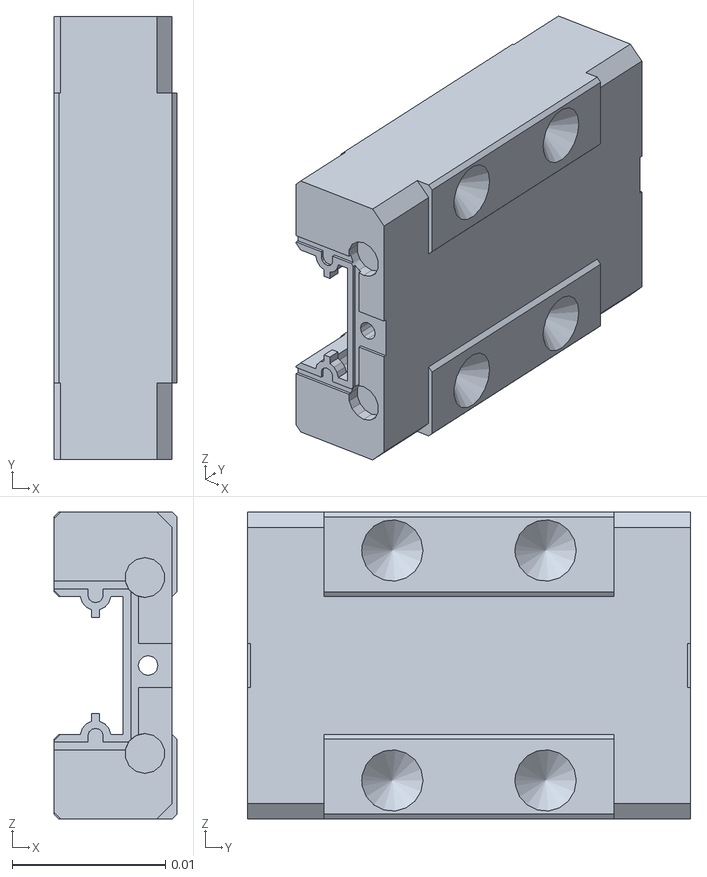
[picture p117: CAD file, 2026-06-01]
reBotArm_simulator/split_meshes/end_link/end_link_part_18_tris_1080.stl
0.008 x 0.0289 x 0.02
