Yang-Ci/Rebot-Arm/reBotArm_simulator/split_meshes/end_link/end_link_part_26_tris_466.stl

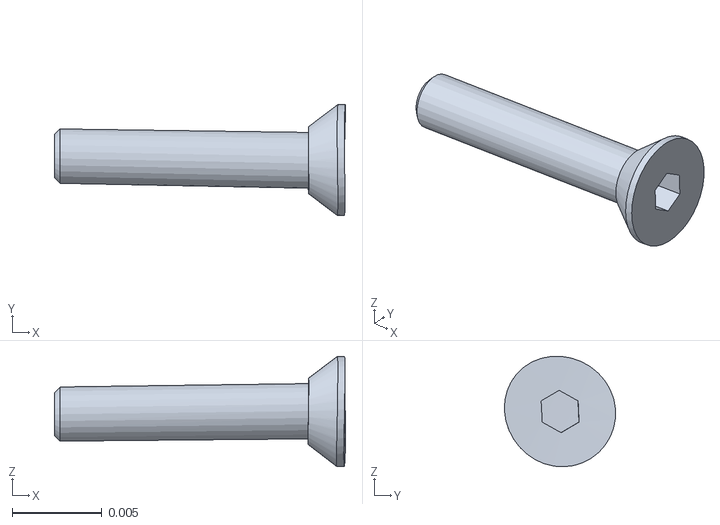
[picture p118: CAD file, 2026-06-01]
reBotArm_simulator/split_meshes/end_link/end_link_part_26_tris_466.stl
0.0162 x 0.00617 x 0.00614
