Yang-Ci/Rebot-Arm/reBotArm_simulator/split_meshes/end_link/end_link_part_14_tris_1610.stl

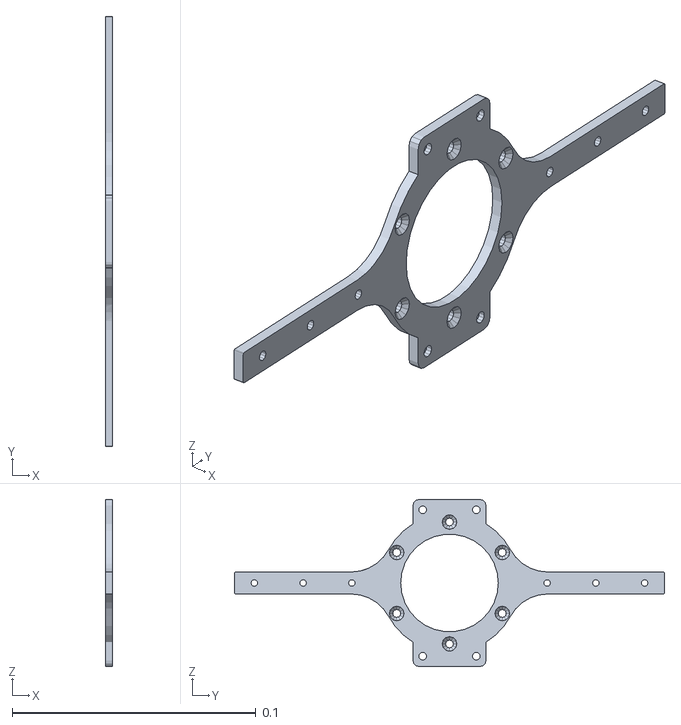
[picture p120: CAD file, 2026-06-01]
reBotArm_simulator/split_meshes/end_link/end_link_part_14_tris_1610.stl
0.003 x 0.176 x 0.0685
