Yang-Ci/Rebot-Arm/reBotArm_simulator/split_meshes/end_link/end_link_part_17_tris_1080.stl

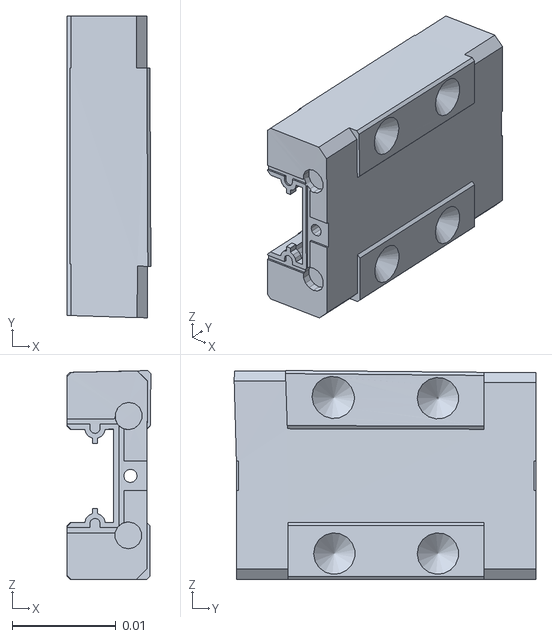
[picture p121: CAD file, 2026-06-01]
reBotArm_simulator/split_meshes/end_link/end_link_part_17_tris_1080.stl
0.0081 x 0.0291 x 0.0202
