Yang-Ci/Rebot-Arm/(list of files, cad)

Other CAD files:
hardware/reBot_B601_DM/3D_Printed_Parts/01_Upper_Arm_Fuller_R.step
reBotArm_simulator/split_meshes/end_link/end_link_part_33_tris_466.stl
reBotArm_simulator/split_meshes/end_link/end_link_part_31_tris_466.stl
reBotArm_simulator/split_meshes/end_link/end_link_part_20_tris_466.stl
hardware/reBot_B601_DM/Metal_Parts/03-Link3_R.step
reBotArm_simulator/split_meshes/end_link/end_link_part_37_tris_322.stl
reBotArm_simulator/split_meshes/end_link/end_link_part_06_tris_8706.stl
reBotArm_simulator/split_meshes/end_link/end_link_part_38_tris_322.stl
hardware/reBot_B601_DM/3D_Printed_Parts/01_Lower_Arm_Filler_L.step
hardware/reBot_B601_DM/Metal_Parts/02_Lower_Upper_Link_L.step
reBotArm_simulator/split_meshes/end_link/end_link_part_40_tris_322.stl
hardware/reBot_B601_DM/Metal_Parts/02_Lower_Wrist_Link_L.step
reBotArm_simulator/split_meshes/end_link/end_link_part_41_tris_322.stl
reBotArm_simulator/split_meshes/end_link/end_link_part_32_tris_466.stl
reBotArm_simulator/split_meshes/end_link/end_link_part_24_tris_466.stl
reBotArm_simulator/split_meshes/end_link/end_link_part_28_tris_466.stl
reBotArm_simulator/split_meshes/end_link/end_link_part_02_tris_9050.stl
reBotArm_simulator/split_meshes/end_link/end_link_part_29_tris_466.stl
reBotArm_simulator/split_meshes/end_link/end_link_part_42_tris_322.stl
reBotArm_simulator/split_meshes/end_link/end_link_part_27_tris_466.stl
reBotArm_simulator/split_meshes/end_link/end_link_part_34_tris_466.stl
reBotArm_simulator/split_meshes/end_link/end_link_part_03_tris_8744.stl
reBotArm_simulator/split_meshes/end_link/end_link_part_08_tris_8614.stl
reBotArm_simulator/split_meshes/end_link/end_link_part_43_tris_310.stl
reBotArm_simulator/split_meshes/end_link/end_link_part_12_tris_2148.stl
reBotArm_simulator/split_meshes/end_link/end_link_part_01_tris_9050.stl
reBotArm_simulator/split_meshes/end_link/end_link_part_30_tris_466.stl
reBotArm_simulator/split_meshes/end_link/end_link_part_04_tris_8744.stl
hardware/reBot_B601_DM/Metal_Parts/02_Rack.step
hardware/reBot_B601_DM/Metal_Parts/03_Link1.step
hardware/reBot_B601_DM/Metal_Parts/03_Link2.step
hardware/reBot_B601_DM/Metal_Parts/03_Link3_L.step
hardware/reBot_B601_DM/Metal_Parts/03_Link3_R.step
hardware/reBot_B601_DM/Metal_Parts/03_Link5.step
