Yang-Ci/Rebot-Arm/hardware/reBot_B601_DM/performance_testing/Performance_Testing_JP.md

# 🧪 reBot-DevArm 実機性能テスト参考

<p align="center">
  reBot-DevArm Banner
</p>

<p align="center">
  <strong>
    <a href="./Performance_Testing_zh.md">简体中文</a> &nbsp;|&nbsp;
    <a href="./Performance_Testing.md">English</a> &nbsp;|&nbsp;
    <a href="./Performance_Testing_JP.md">日本語</a>&nbsp;|&nbsp;
    <a href="./Performance_Testing_Fr.md">français</a>&nbsp;|&nbsp;
    <a href="./Performance_Testing_es.md">Español</a>
  </strong>
</p>

> [!NOTE]
> 本ドキュメントは、reBot Arm B601-DM の通常および極限条件における性能テストデータの参考を提供します。

> [!WARNING]
> **バージョン差異について**：本テストは **Damiao V4 バージョンのモーター** を搭載した reBot Arm B601-DM に基づいています。V3 およびそれ以前のバージョンとは性能が異なります。本データは参考値であり、実際の性能は実機での測定結果をご確認ください。

---

## 📋 目次

- [⚡ 極限動作性能テスト](#-極限動作性能テスト)
- [📈 公式負荷曲線](#-公式負荷曲線)
- [📝 テスト結論と推奨事項](#-テスト結論と推奨事項)
- [🙋 よくある質問 (FAQ)](#-よくある質問-faq)
- [📅 更新履歴](#-更新履歴)
- [📞 技術サポート](#-技術サポート)

---

## ⚡ 極限動作性能テスト

### テスト条件

**動的動作テスト**：
- 単一動作時間：5 秒
- 動作モード：往復運動
- テストアーム範囲：定格アーム長の 5%～70% / 5%～100%

**静止保持テスト**：
- テスト姿勢：静止状態での負荷保持
- アーム伸長：定格アーム長の 70% / 100%

### テスト結果

> 👉 **主要結論**：機械構造の強度は十分です。テスト終了の原因は **第2モーターの過熱保護** でした。推奨負荷は **1.5 kg 以下**、推奨作業範囲は **70% 未満**、さらにアクティブ冷却の追加を推奨します。

#### 1. 動的動作テスト

| アーム範囲 | 負荷 | 持続時間 | 終了原因 |
|---|---|---|---|
| 5%～70% 範囲で往復運動 | 1.5 kg | > 2 時間 | 第2モーターが90℃に達し手動停止 |
| 5%～70% 範囲で往復運動 | 2.5 kg | 40 分 | 過熱保護作動 |
| 5%～100% 範囲で往復運動 | 1.5 kg | 45 分 | 過熱保護作動 |

#### 2. 静止保持テスト

| テスト位置 | 負荷 (kg) | 最大持続時間 | 終了原因 |
|---|---|---|---|
| アーム70%で保持 | 1.5 | 18 分 | 過熱保護 |
| アーム100%で保持 | 1.5 | 3 分 | 過熱保護 |

---

## 📈 公式負荷曲線

12Nm 负载曲线图

<p align="center">Damiao 43シリーズモーター 12Nm バージョン負荷曲線</p>

---

## 📝 テスト結論と推奨事項

### 使用に関する推奨

1. **推奨作業条件**
   - 負荷：< 1.5 kg
   - 作業半径：アーム長の 70% 未満（450 mm）
   - 動作速度：最大速度の 70% 未満
   - 環境温度：15 °C ～ 35 °C

2. **冷却に関する推奨**
   - 長時間の高負荷運転時にはアクティブ冷却を追加すること
   - 連続稼働 2 時間後は 10～15 分の休止を推奨
   - 直射日光や密閉空間での使用を避ける

---

## 🙋 よくある質問 (FAQ)

<details>
<summary><b>Q1: 高温環境では性能は低下しますか？</b></summary>

はい。環境温度が 35 °C を超える場合、またはモーター温度が 75 °C を超える場合は、精度と寿命を確保するために負荷と速度を下げることを推奨します。高温環境での長時間使用は推奨されません。

</details>

<details>
<summary><b>Q2: テストデータはすべてのバージョンに適用されますか？</b></summary>

本テストは **Damiao V4 モーター** を搭載したモデルに基づいています。V3 およびそれ以前のバージョンでは性能が異なり、本データは参考値です。

</details>

---

## 📅 更新履歴

| バージョン | 日付 | 更新内容 | 作者 |
|---|---|---|---|
| v1.0 | 2026.04.01 | 初版、基本性能テストデータを公開 | SeeedStudio AI Robotics Team |

---

## 📞 技術サポート

性能テストに関するご質問がございましたら、お気軽にお問い合わせください：

- **技術サポート**: yaohui.zhu@seeed.cc
- **Discord**: [コミュニティに参加](https://discord.gg/AbGuqJhDpQ)
- **Wiki**: [ナレッジベースを見る](https://wiki.seeedstudio.com/robotics_page/)

---

<p align="center">
  <strong>🤖 reBot-DevArm - すべての開発者のためのオープンソースロボットアーム</strong>
</p>
