Yang-Ci/Rebot-Arm/hardware/reBot_B601_DM/performance_testing/Performance_Testing_zh.md

# 🧪 reBot-DevArm 真机性能测试参考

<p align="center">
  reBot-DevArm Banner
</p>

<p align="center">
  <strong>
    <a href="./Performance_Testing_zh.md">简体中文</a> &nbsp;|&nbsp;
    <a href="./Performance_Testing.md">English</a> &nbsp;|&nbsp;
    <a href="./Performance_Testing_JP.md">日本語</a>&nbsp;|&nbsp;
    <a href="./Performance_Testing_Fr.md">français</a>&nbsp;|&nbsp;
    <a href="./Performance_Testing_es.md">Español</a>
  </strong>
</p>

> [!NOTE]
> 本文档提供 reBot Arm B601-DM 机械臂在常规工作及极限工作条件下的性能测试数据参考。

> [!WARNING]
> **版本差异提示**：本测试基于搭载 **达妙 V4 版本电机** 的 reBot Arm B601-DM。**V3 及之前版本的电机性能存在差异**，测试数据仅供参考，实际性能请以实测为准。

---

## 📋 目录

- [⚡ 极限工作性能测试](#-极限工作性能测试)
- [📈 官方负载曲线](#-官方负载曲线)
- [📝 测试结论与建议](#-测试结论与建议)
- [🙋 常见问题 (FAQ)](#-常见问题-faq)
- [📅 更新记录](#-更新记录)
- [📞 技术支持](#-技术支持)

---

## ⚡ 极限工作性能测试

### 测试条件

**动态运动测试**：
- 单组动作时长：5 s
- 运动模式：往复运动
- 测试臂展区间：5%~70% / 5%~100% 额定臂长

**静止保持测试**：
- 测试姿态：静止姿态负载静置
- 测试臂展：70% / 100% 额定臂长

### 测试结果

> 👉 **核心结论**：机械臂结构强度充足，测试终止原因为 **2 号电机过热保护**。推荐工作负载 **1.5 kg 及以下**，工作臂展建议 **小于 70%**，并建议增加主动散热措施。

#### 1. 动态运动测试

| 臂展区间 | 负载 | 持续时间 | 终止原因 |
|---|---|---|---|
| 5%至70% 工作空间往复运动 | 1.5 kg | > 2 h | 2 号电机温度达 90℃，人为介入终止 |
| 5%至70% 工作空间往复运动 | 2.5 kg | 40 min | 2 号电机触发过热保护 |
| 5%至100% 工作空间往复运动 | 1.5 kg | 45 min | 2 号电机触发过热保护 |

#### 2. 静止保持测试

| 测试位置 | 负载 (kg) | 最长持续时间 | 终止原因 |
|---|---|---|---|
| 臂展 70% 悬停 | 1.5 | 18 min | 2 号电机过热保护 |
| 臂展 100% 悬停 | 1.5 | 3 min | 2 号电机过热保护 |

---

## 📈 官方负载曲线

12Nm 负载曲线图

<p align="center">达妙 43 系列电机 12Nm 版本负载曲线</p>

---

## 📝 测试结论与建议

### 使用建议

1. **推荐工作条件**
   - 负载：< 1.5 kg
   - 工作半径：< 70% 臂展（450 mm）
   - 运动速度：< 70% 最大速度
   - 环境温度：15 °C ~ 35 °C

2. **散热建议**
   - 长时间高负载工作时，建议增加主动散热
   - 连续工作 2 小时后，建议休息 10~15 分钟
   - 避免阳光直射和密闭空间使用

---

## 🙋 常见问题 (FAQ)

<details>
<summary><b>Q1: 机械臂在高温环境下性能会下降吗？</b></summary>

是的。当环境温度超过 35 °C 或电机温度超过 75 °C 时，建议降低负载和运动速度以保证精度和寿命。不建议在高温下持续使用。

</details>

<details>
<summary><b>Q2: 测试数据是否适用于所有版本？</b></summary>

本测试基于搭载 **达妙 V4 版本电机** 的 reBot Arm B601-DM。**V3 及之前版本的电机性能存在差异**，测试数据仅供参考。

</details>

---

## 📅 更新记录

| 版本 | 日期 | 更新内容 | 作者 |
|---|---|---|---|
| v1.0 | 2026.04.01 | 初始版本，发布基础性能测试数据 | SeeedStudio AI Robotics Team |

---

## 📞 技术支持

如有任何性能测试相关问题，欢迎联系我们：

- **技术支持**: yaohui.zhu@seeed.cc
- **Discord**: [加入社区](https://discord.gg/AbGuqJhDpQ)
- **Wiki**: [查看知识库](https://wiki.seeedstudio.com/robotics_page/)

---

<p align="center">
  <strong>🤖 reBot-DevArm - 为每个开发者开源的机械臂</strong>
</p>
