Yang-Ci/Rebot-Arm/(commit log)

2026-06-01 chore: 发布网页模拟与 ROS2 Jazzy 云端接通版本
    包含 reBotArm 网页模拟器、ROS2 Jazzy 控制工作空间、URDF/网格资源、硬件资料与多语言 README。
    模拟器支持通过 rosbridge WebSocket 连接 ROS2 Jazzy 环境，并提供 HTTPS/PWA 与远程访问配置说明，便于网页端仿真、调试和云端接通。
    版本重点：网页模拟、ROS2 Jazzy、云端/远程接通。
    [01-Rail-Bracket.step, 01_Arm_Handle.step, 01_BASE_Link.step, 01_BASE_Plate.step, 01_Finger.step, 01_Joint5_Cable Restraint_A.step, 01_Joint6_7_Cable Restraint_A.step, 01_Joint6_7_Cable Restraint_B.step]
2026-06-01 docs: 更新网页仿真首页截图
