Yang-Ci/Rebot-Arm/(notices)

Notices in the files:
README.md:
License: CERN-OHL-W-2.0
License: Apache-2.0
